jamesath3d/kicad01/kicad01_power_board_for_nuclear_team/pdfs/res_list.pdf

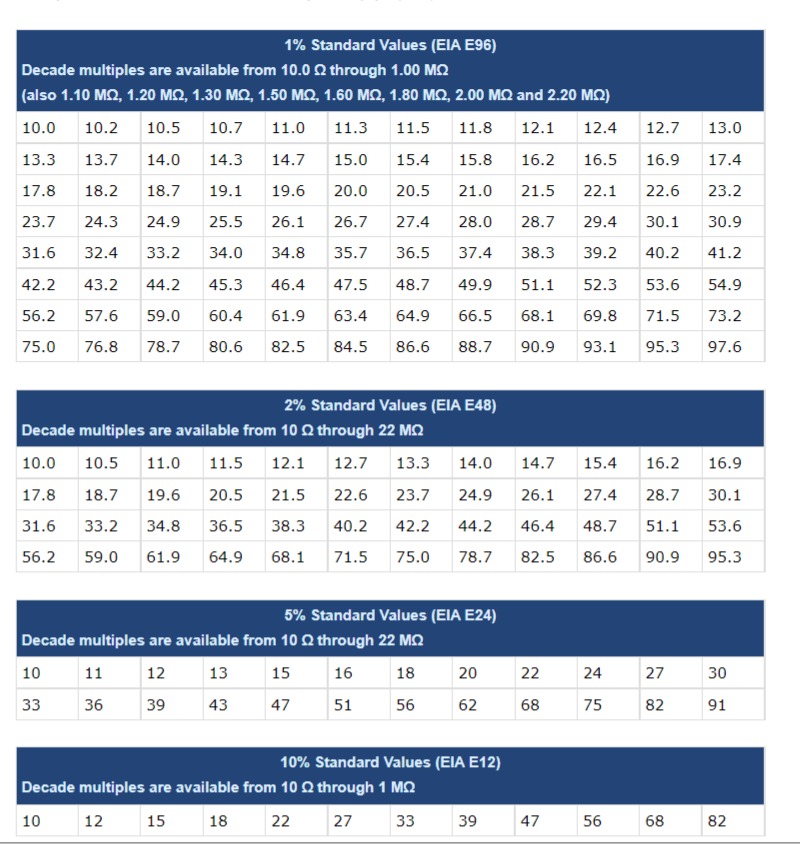
[picture p1: page 1]
