jamesath3d/kicad01/kicad01_power_board_for_nuclear_team/3d/ptc_fuse_2920.step

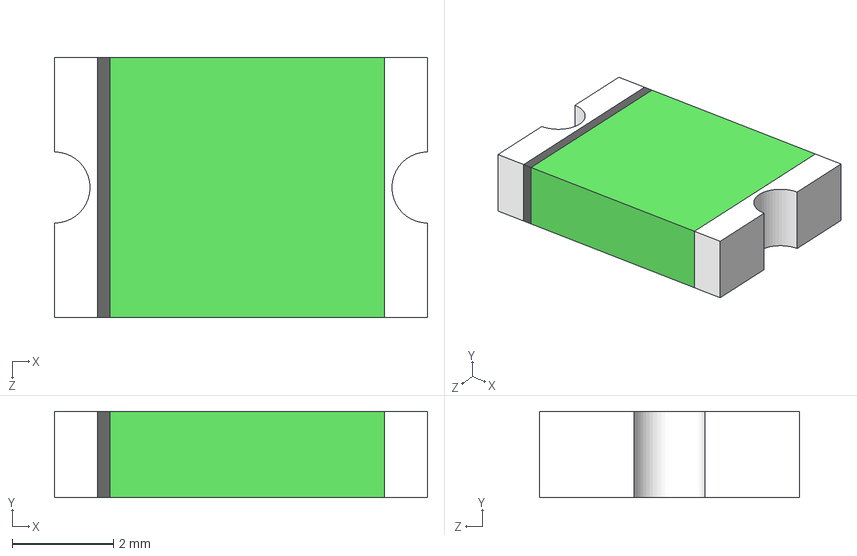
[picture p2: CAD file, 2022-02-18]
kicad01_power_board_for_nuclear_team/3d/ptc_fuse_2920.step
7.36 x 1.70 x 5.12 mm
