jamesath3d/kicad01/kicad01_power_board_for_nuclear_team/kicad01_power_board_for_nuclear_team.step

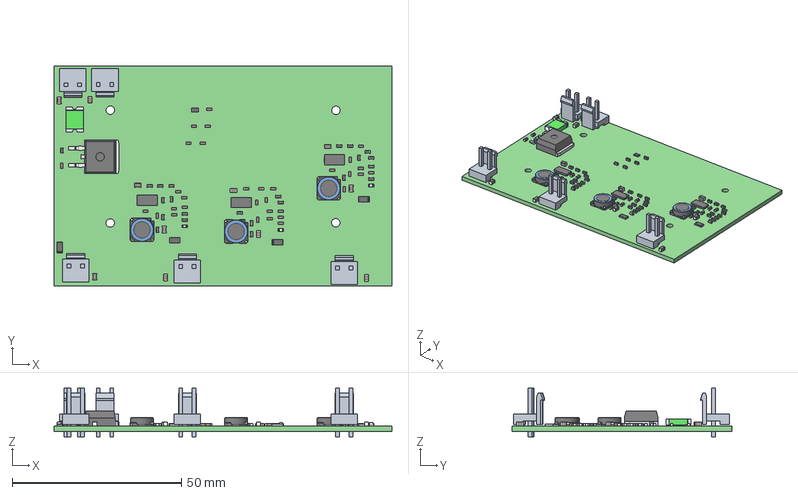
[picture p3: CAD file, 2022-02-25]
kicad01_power_board_for_nuclear_team/kicad01_power_board_for_nuclear_team.step
99.9 x 65.0 x 14.4 mm
kicad01_power_board_for_nuclear_team PCB
