jamesath3d/kicad01/kicad01_power_board_for_nuclear_team/3d/1-1123723-2.step

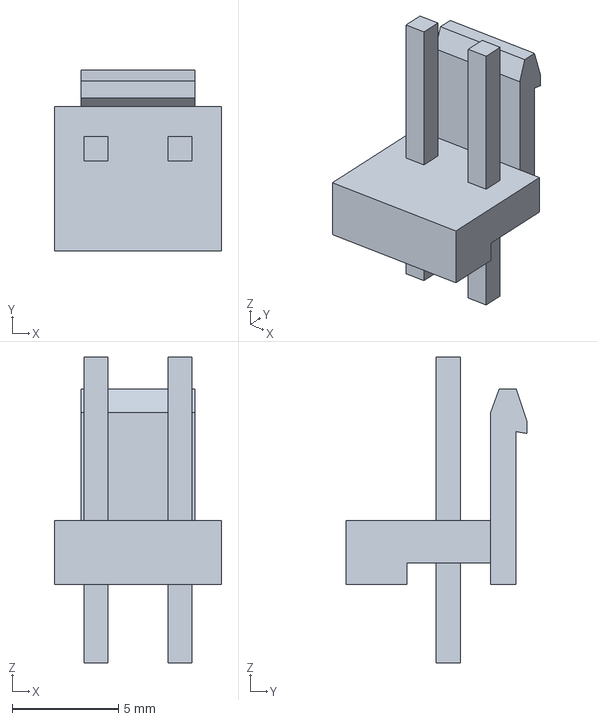
[picture p4: CAD file, 2022-02-18]
kicad01_power_board_for_nuclear_team/3d/1-1123723-2.step
7.86 x 8.50 x 14.4 mm
