jamesath3d/kicad01/kicad01_power_board_for_nuclear_team/pdfs/header_a111830_ENG_CD_1123723_AA4.pdf

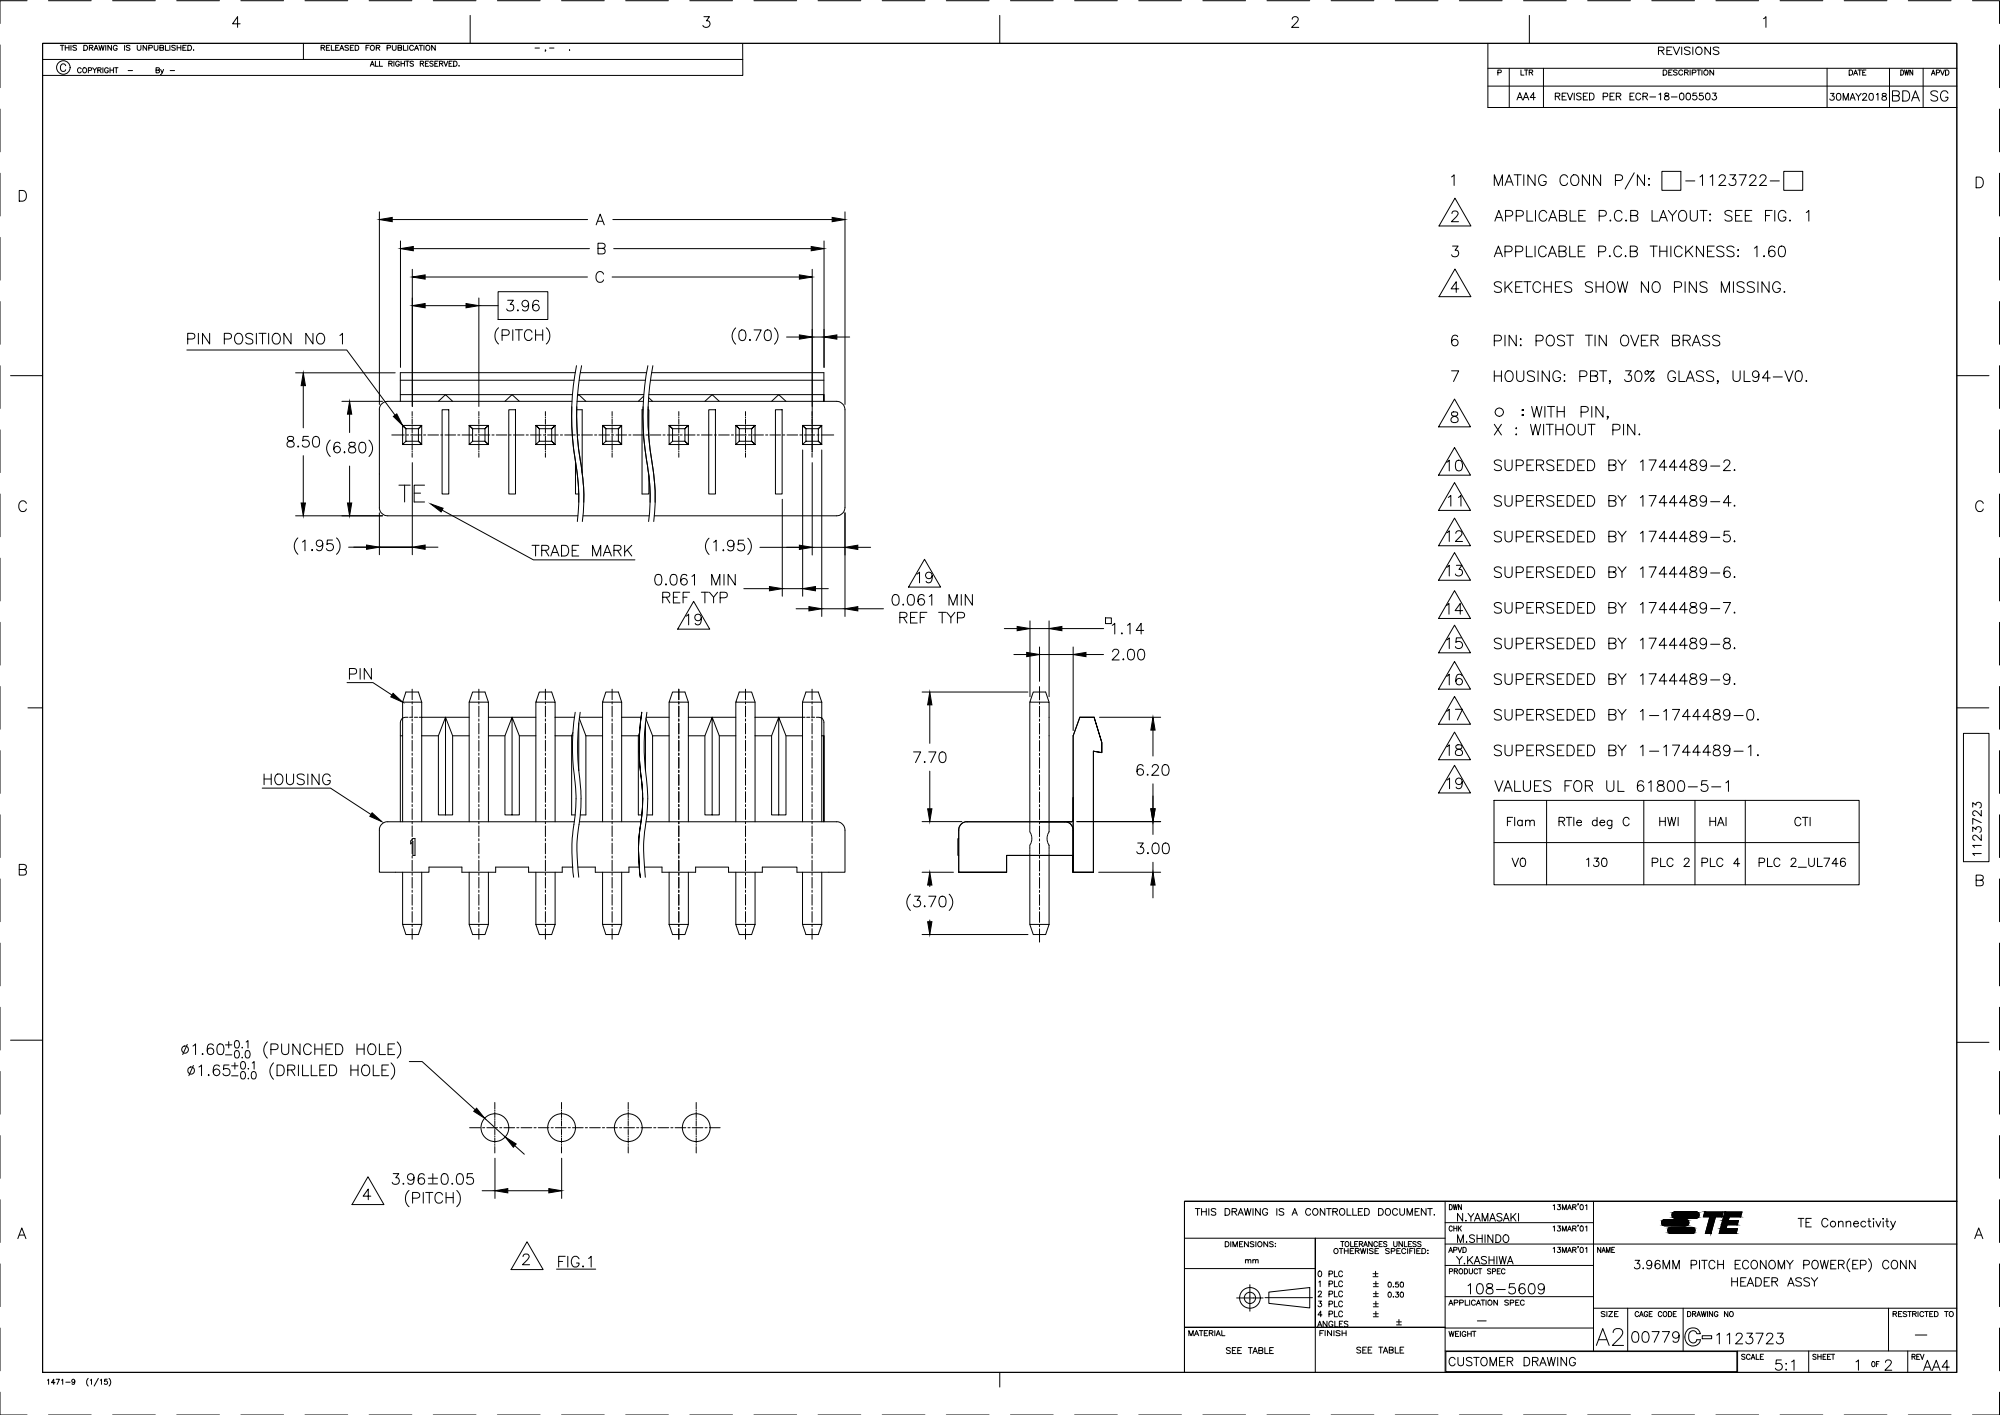
[picture p5: page 1]

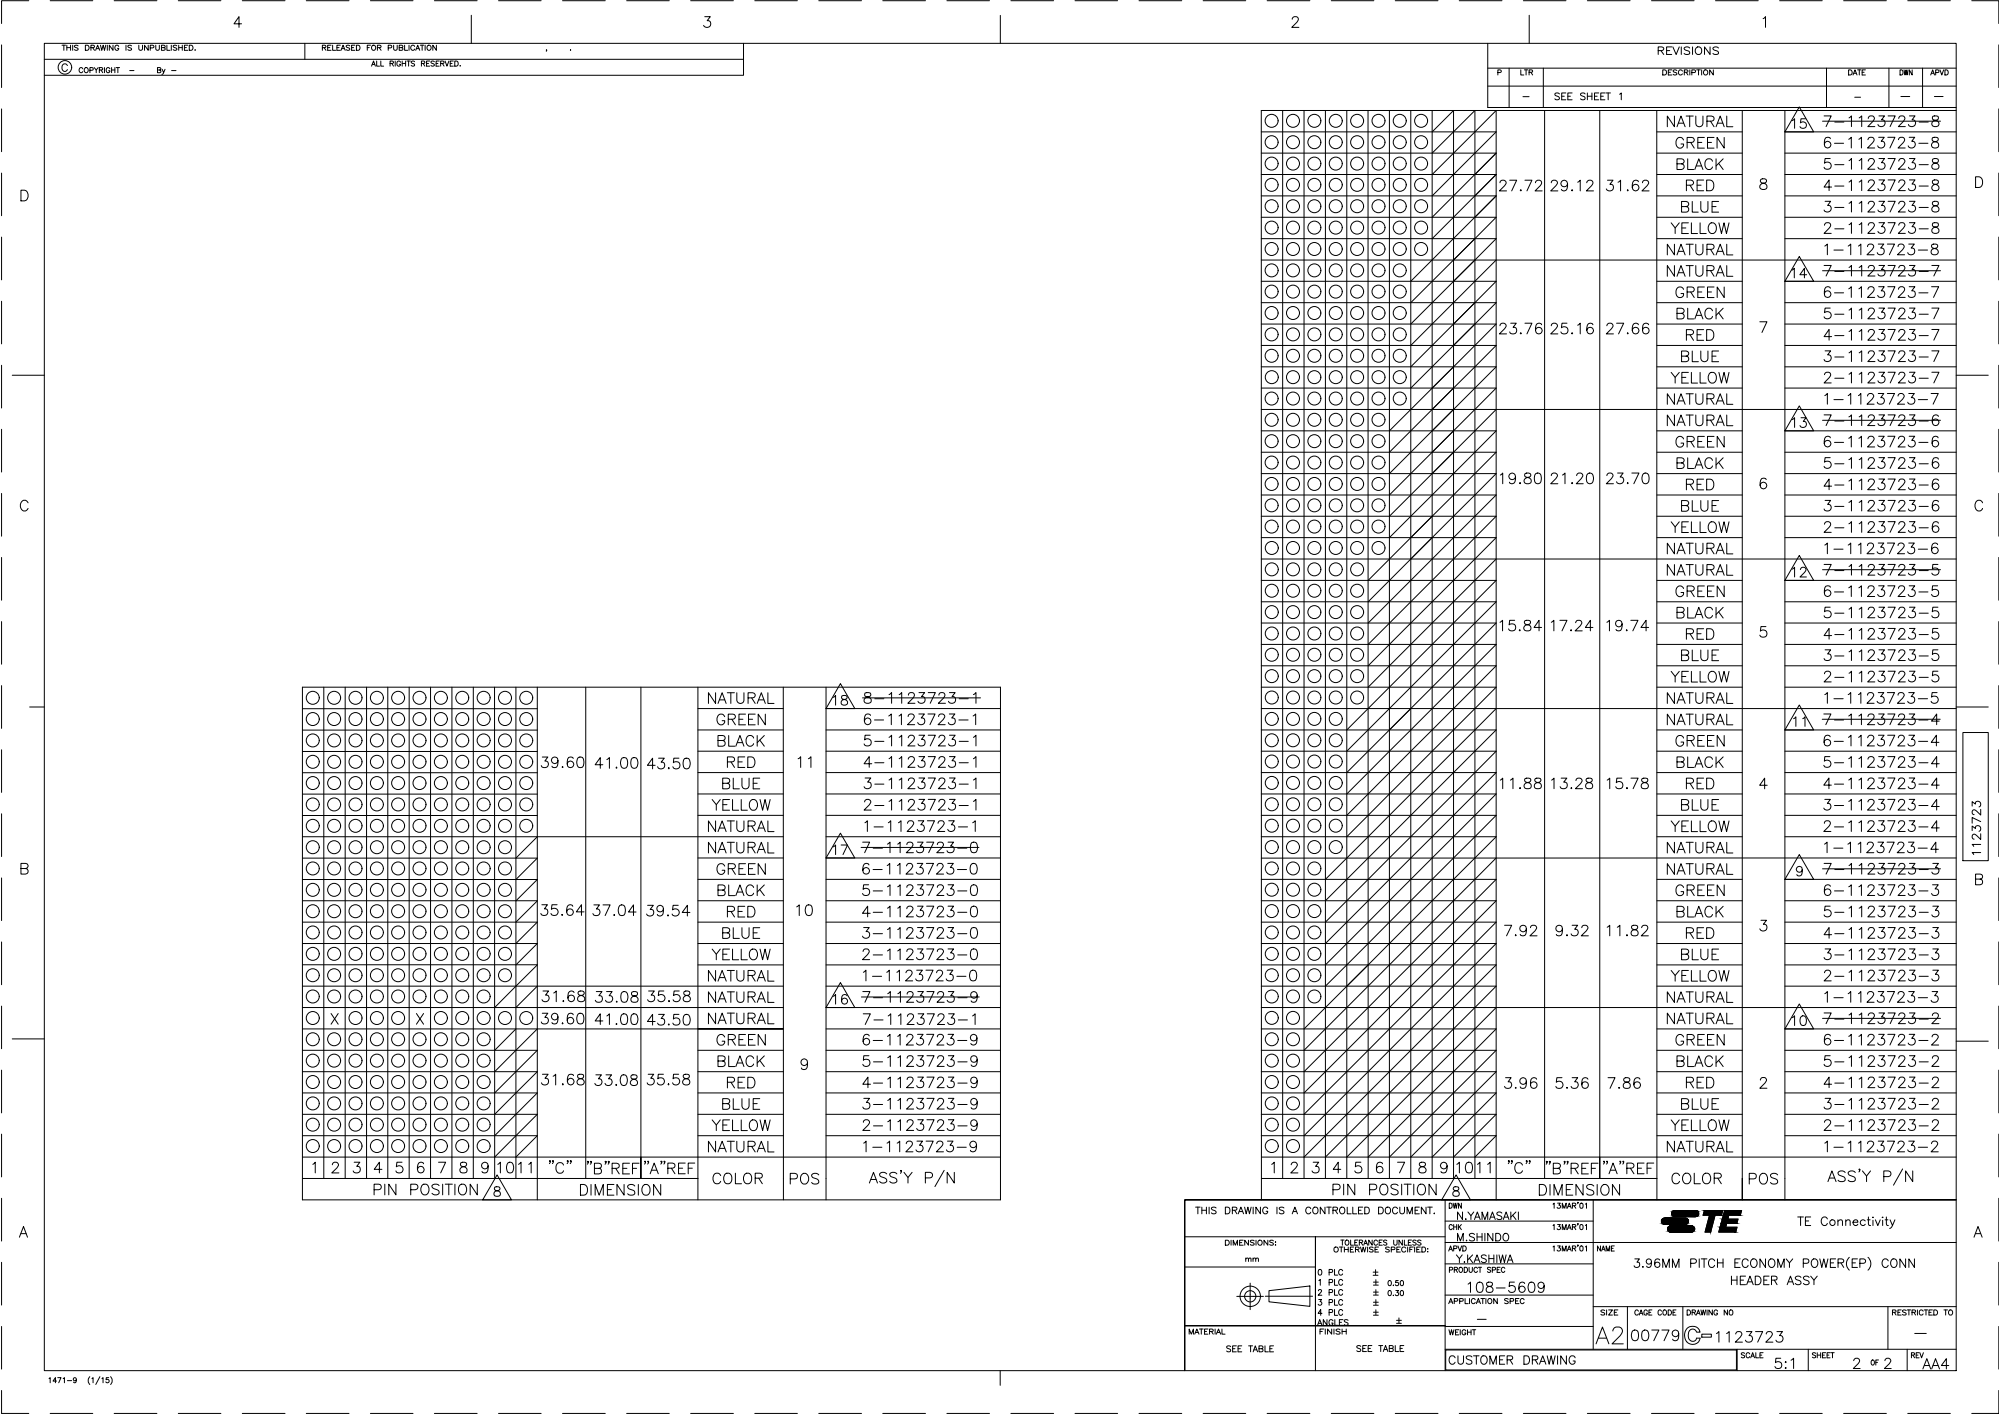
[picture p6: page 2]
