jamesath3d/kicad01/kicad01_power_board_for_nuclear_team/kicad01_power_board_for_nuclear_team.kicad_pcb

## KiCad design kicad01_power_board_for_nuclear_team/kicad01_power_board_for_nuclear_team.kicad_pcb (2022-03-01)

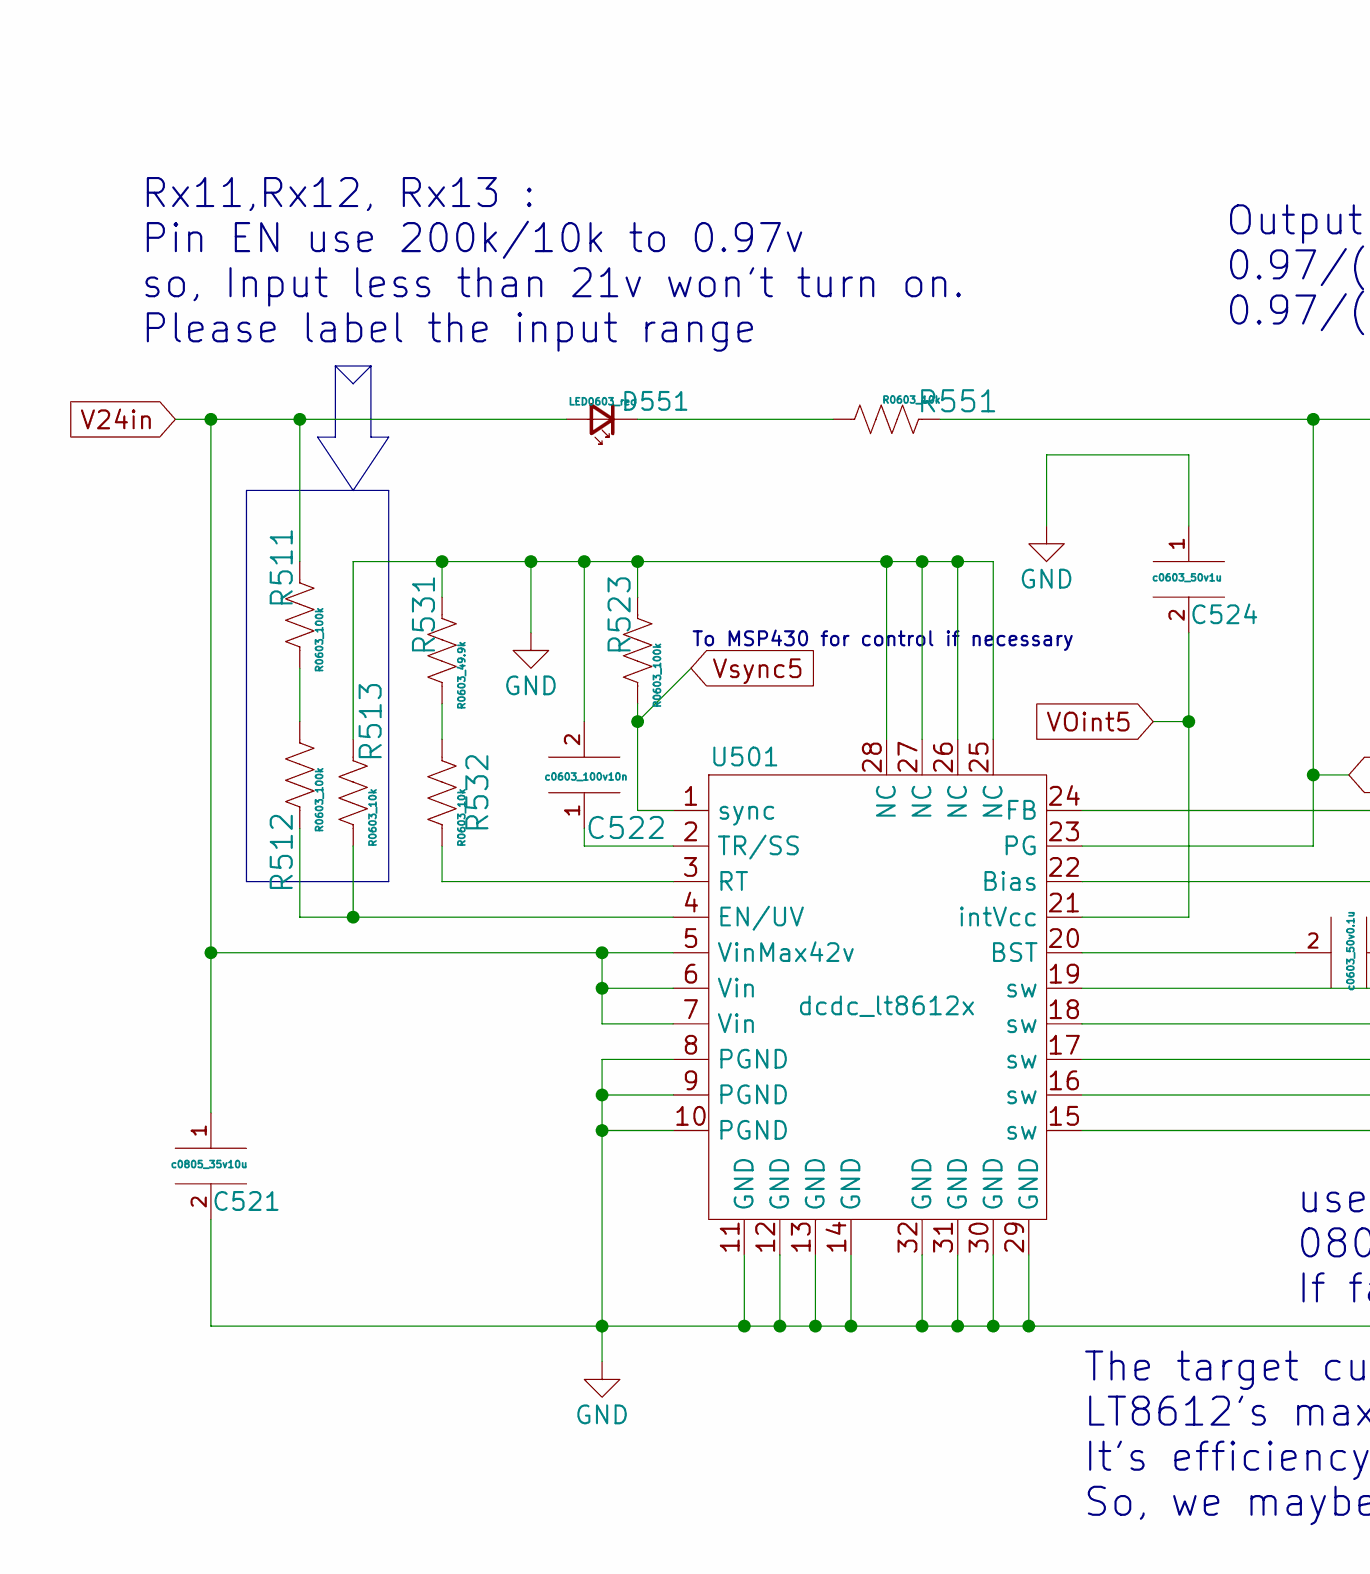
[picture p7: schematic 005_dcdc_5v3a.kicad_sch, part in row 1, column 1]

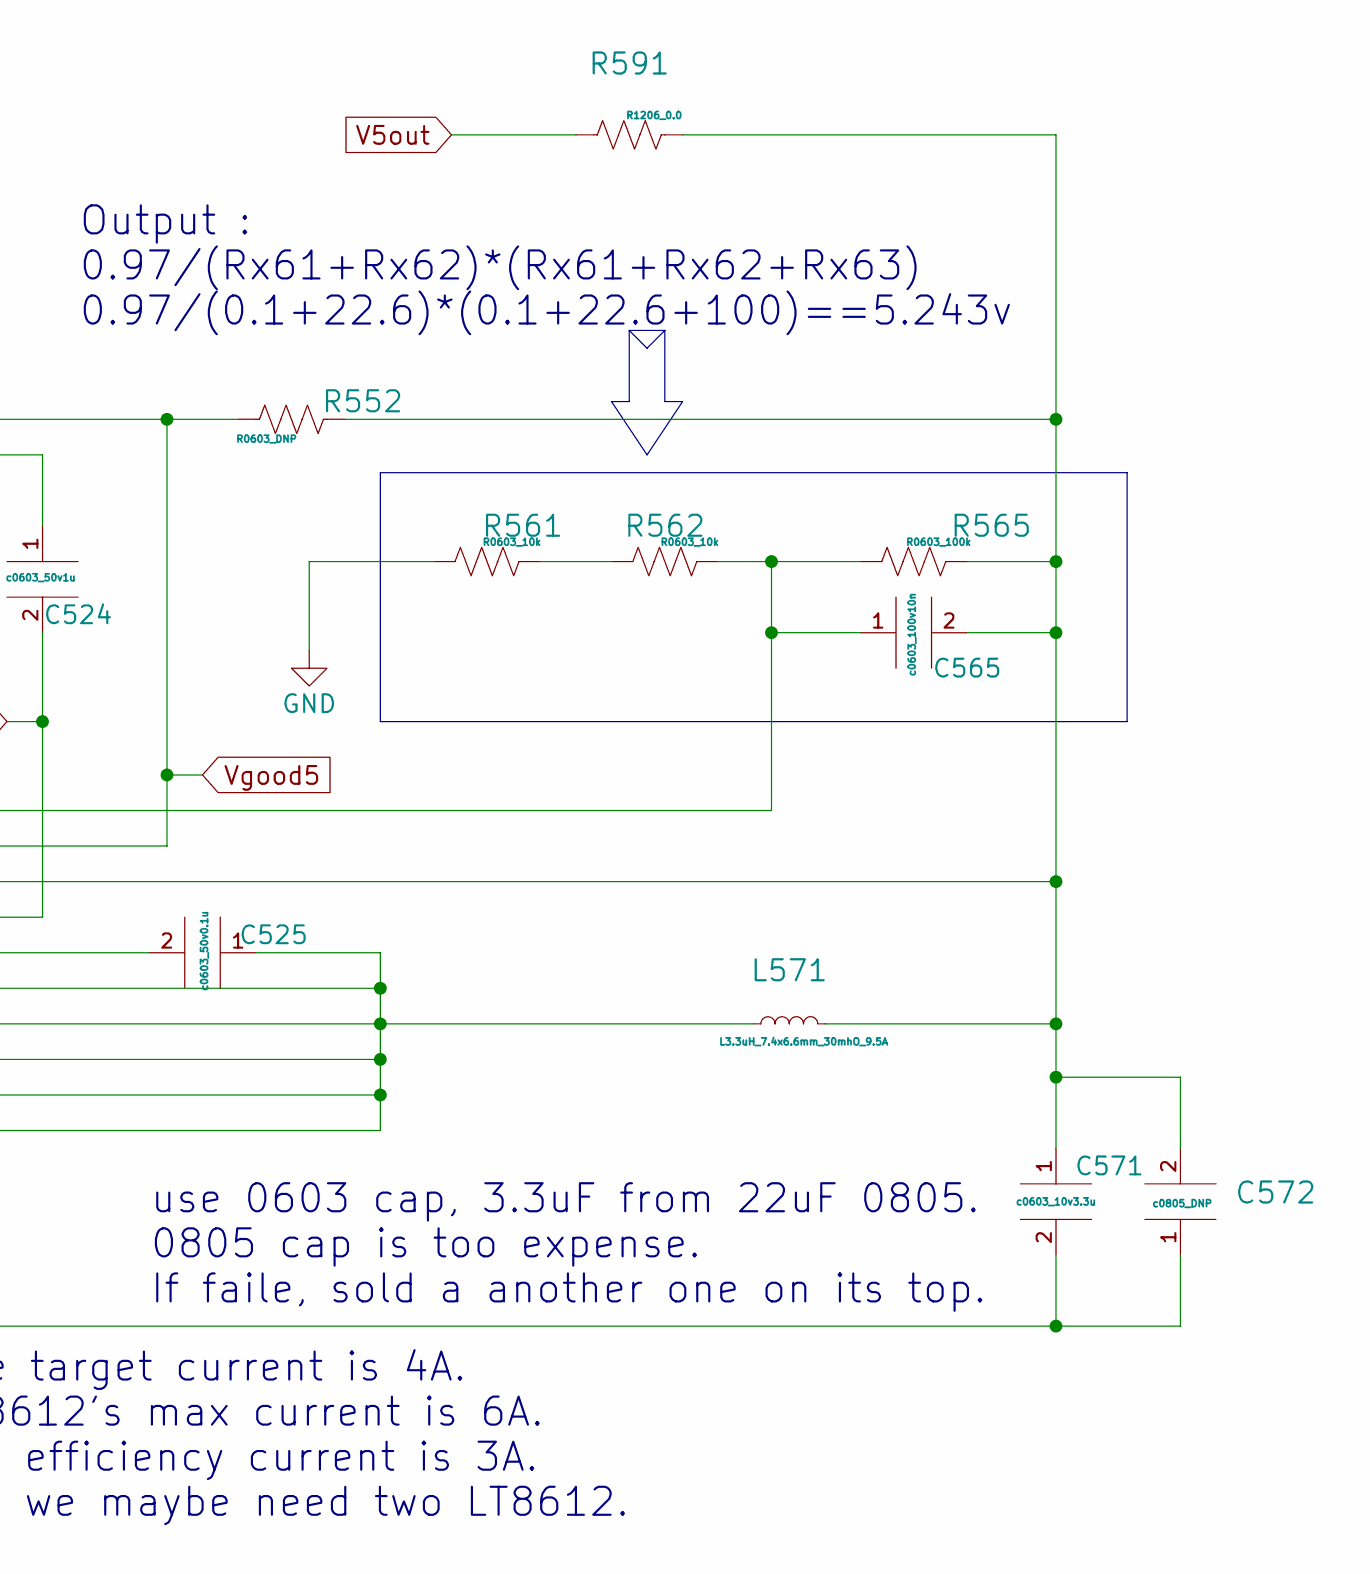
[picture p8: schematic 005_dcdc_5v3a.kicad_sch, part in row 1, column 2]

Parts:
C521: c0805_35v10u; C0805mix0603; PartNum C2012X5R1V106M085AC
C522, C565: c0603_100v10n; C0603; PartNum C1608X7R2A103M080AA
C524: c0603_50v1u; C0603; PartNum C1608X5R1H105K080AB
C525: c0603_50v0.1u; C0603; PartNum CGA3E2X7R1H104M080AA
C571: c0603_10v3.3u; C0603; PartNum C1608X7S1A335K080AC
C572: c0805_DNP; C0805mix0603; PartNum c0805_DNP
D551: LED0603_red; LED0603; PartNum LTST-C190KRKT
L571: L3.3uH_7.4x6.6mm_30mhO_9.5A; L7.1x6.6mm; PartNum ECS-MPIL0630-3R3MC
R511, R512, R523, R565: R0603_100k; C0603; PartNum ERA-3AED104V
R513, R532, R551, R561, R562: R0603_10k; C0603; PartNum ERJ-PA3F1002V
R531: R0603_49.9k; C0603; PartNum ERA-3AED4992V
R552: R0603_DNP; C0603; PartNum R0603_DNP
R591: R1206_0.0; R1206mix0603; PartNum RC1206FR-070RL
U501: dcdc_lt8612x; QFN-28-1EP_3x6mm_P0.5mm_EP1.7x4.75mmX; PartNum 505-LT8612EUDE#PBF-ND

Connections:
GND: C521.2, C522.2, C524.1, C571.2, C572.1, R513.2, R523.2, R531.2, R561.2, U501.8 (PGND), U501.9 (PGND), U501.10 (PGND), U501.11 (GND), U501.12 (GND), U501.13 (GND), U501.14 (GND), U501.25 (NC), U501.26 (NC), U501.27 (NC), U501.28 (NC), U501.29 (GND), U501.30 (GND), U501.31 (GND), U501.32 (GND); also elsewhere on the board
unnamed: C522.1, U501.2 (TR/SS)
unnamed: C525.1, L571.1, U501.15 (sw), U501.16 (sw), U501.17 (sw), U501.18 (sw), U501.19 (sw)
unnamed: C525.2, U501.20 (BST)
unnamed: C565.1, R562.1, R565.2, U501.24 (FB)
unnamed: C565.2, C571.1, C572.2, L571.2, R552.2, R565.1, R591.1, U501.22 (Bias)
unnamed: D551.1 (K), R551.2
unnamed: R511.1, R512.2
unnamed: R512.1, R513.1, U501.4 (EN/UV)
unnamed: R531.1, R532.2
unnamed: R532.1, U501.3 (RT)
unnamed: R561.1, R562.2
V5out: R591.2; also elsewhere on the board
V24in: C521.1, D551.2 (A), R511.2, U501.5 (VinMax42v), U501.6 (Vin), U501.7 (Vin); also elsewhere on the board
VOint5: C524.2, U501.21 (intVcc)
Vgood5: R551.1, R552.1, U501.23 (PG)
Vsync5: R523.1, U501.1 (sync)

Notes on the sheet:
use 0603 cap, 3.3uF from 22uF 0805. 0805 cap is too expense. If faile, sold a another one on its top.
To MSP430 for control if necessary
The target current is 4A. LT8612's max current is 6A. It's efficiency current is 3A. So, we maybe need two LT8612.
Output : 0.97/(Rx61+Rx62)*(Rx61+Rx62+Rx63) 0.97/(0.1+22.6)*(0.1+22.6+100)==5.243v
Rx11,Rx12, Rx13 : Pin EN use 200k/10k to 0.97v so, Input less than 21v won't turn on. Please label the input range

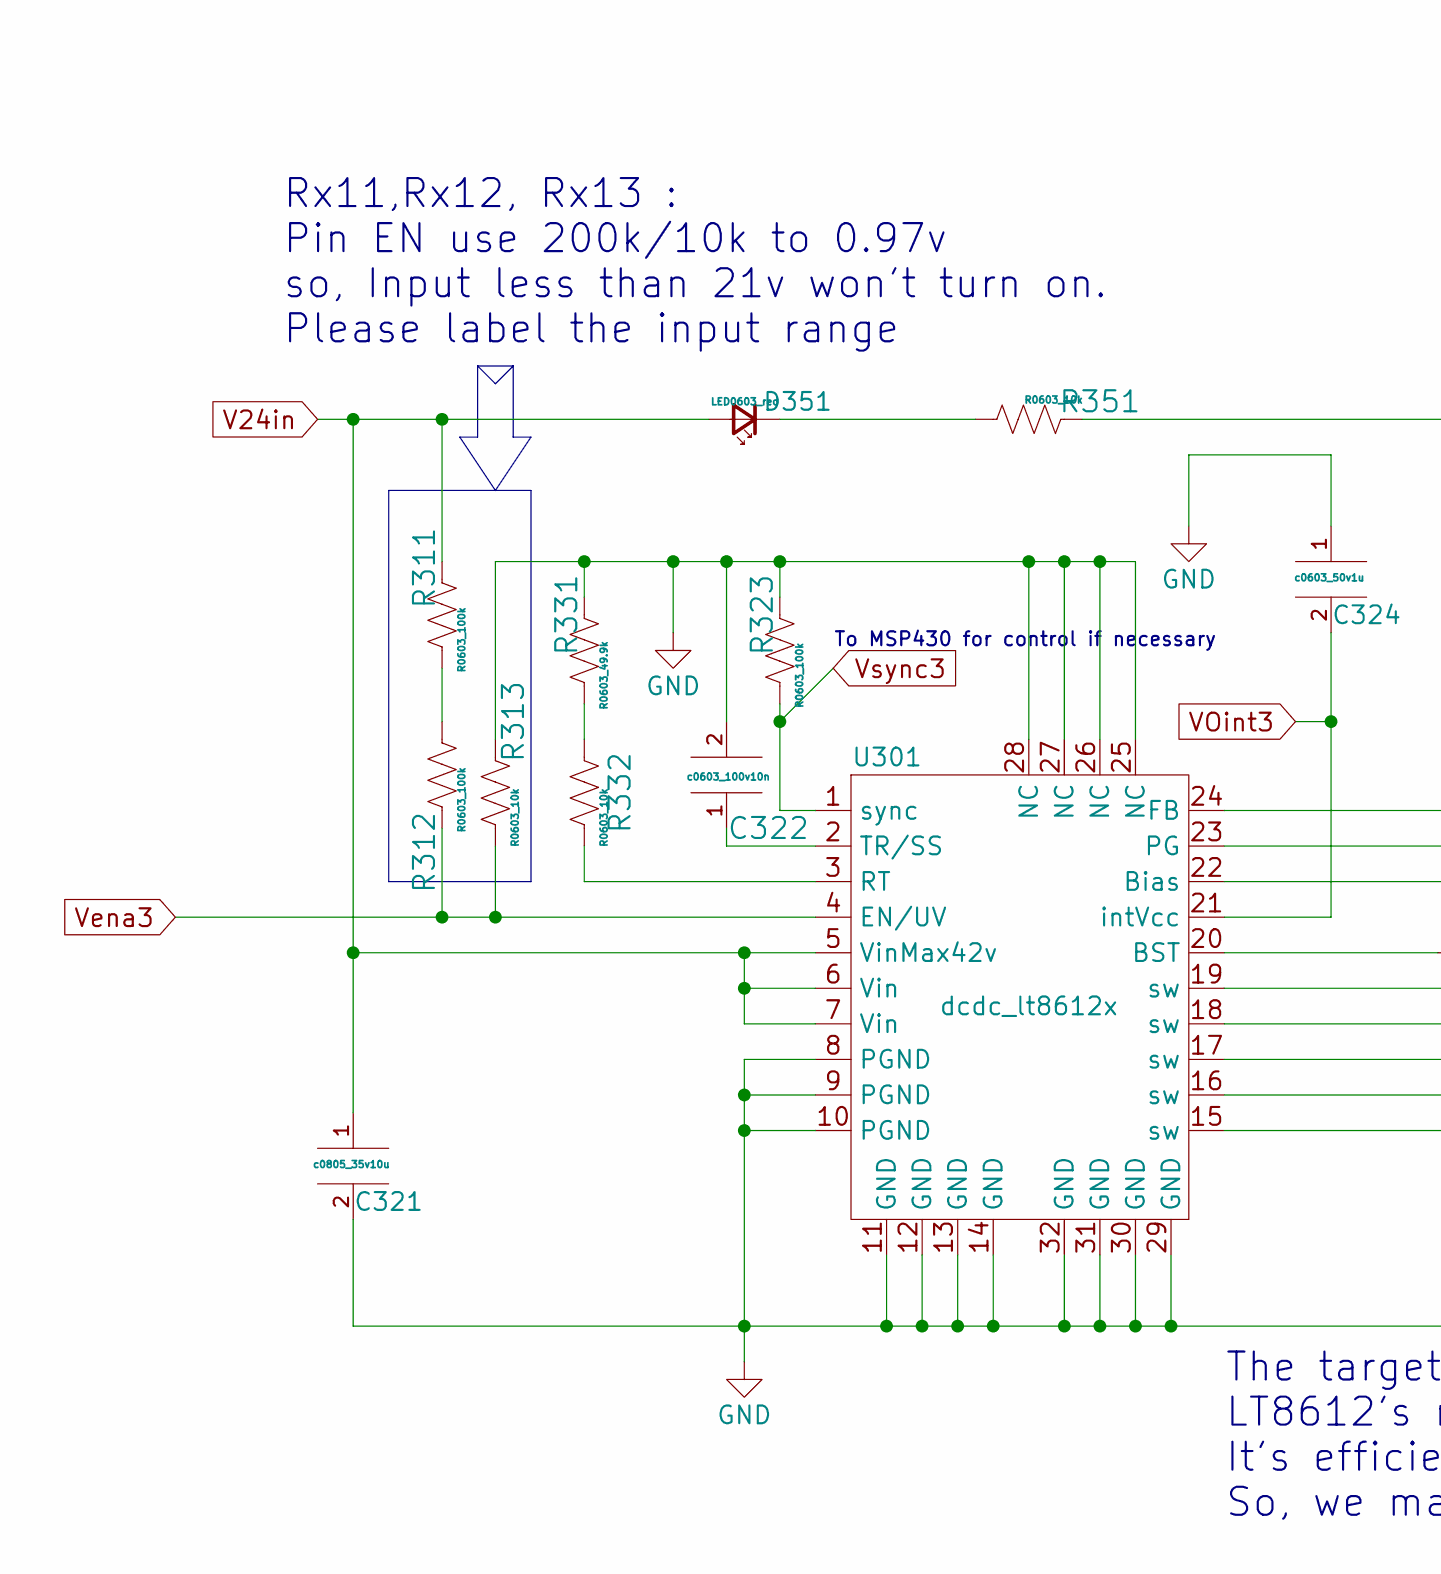
[picture p9: schematic 003_dcdc_18v4a.kicad_sch, part in row 1, column 1]

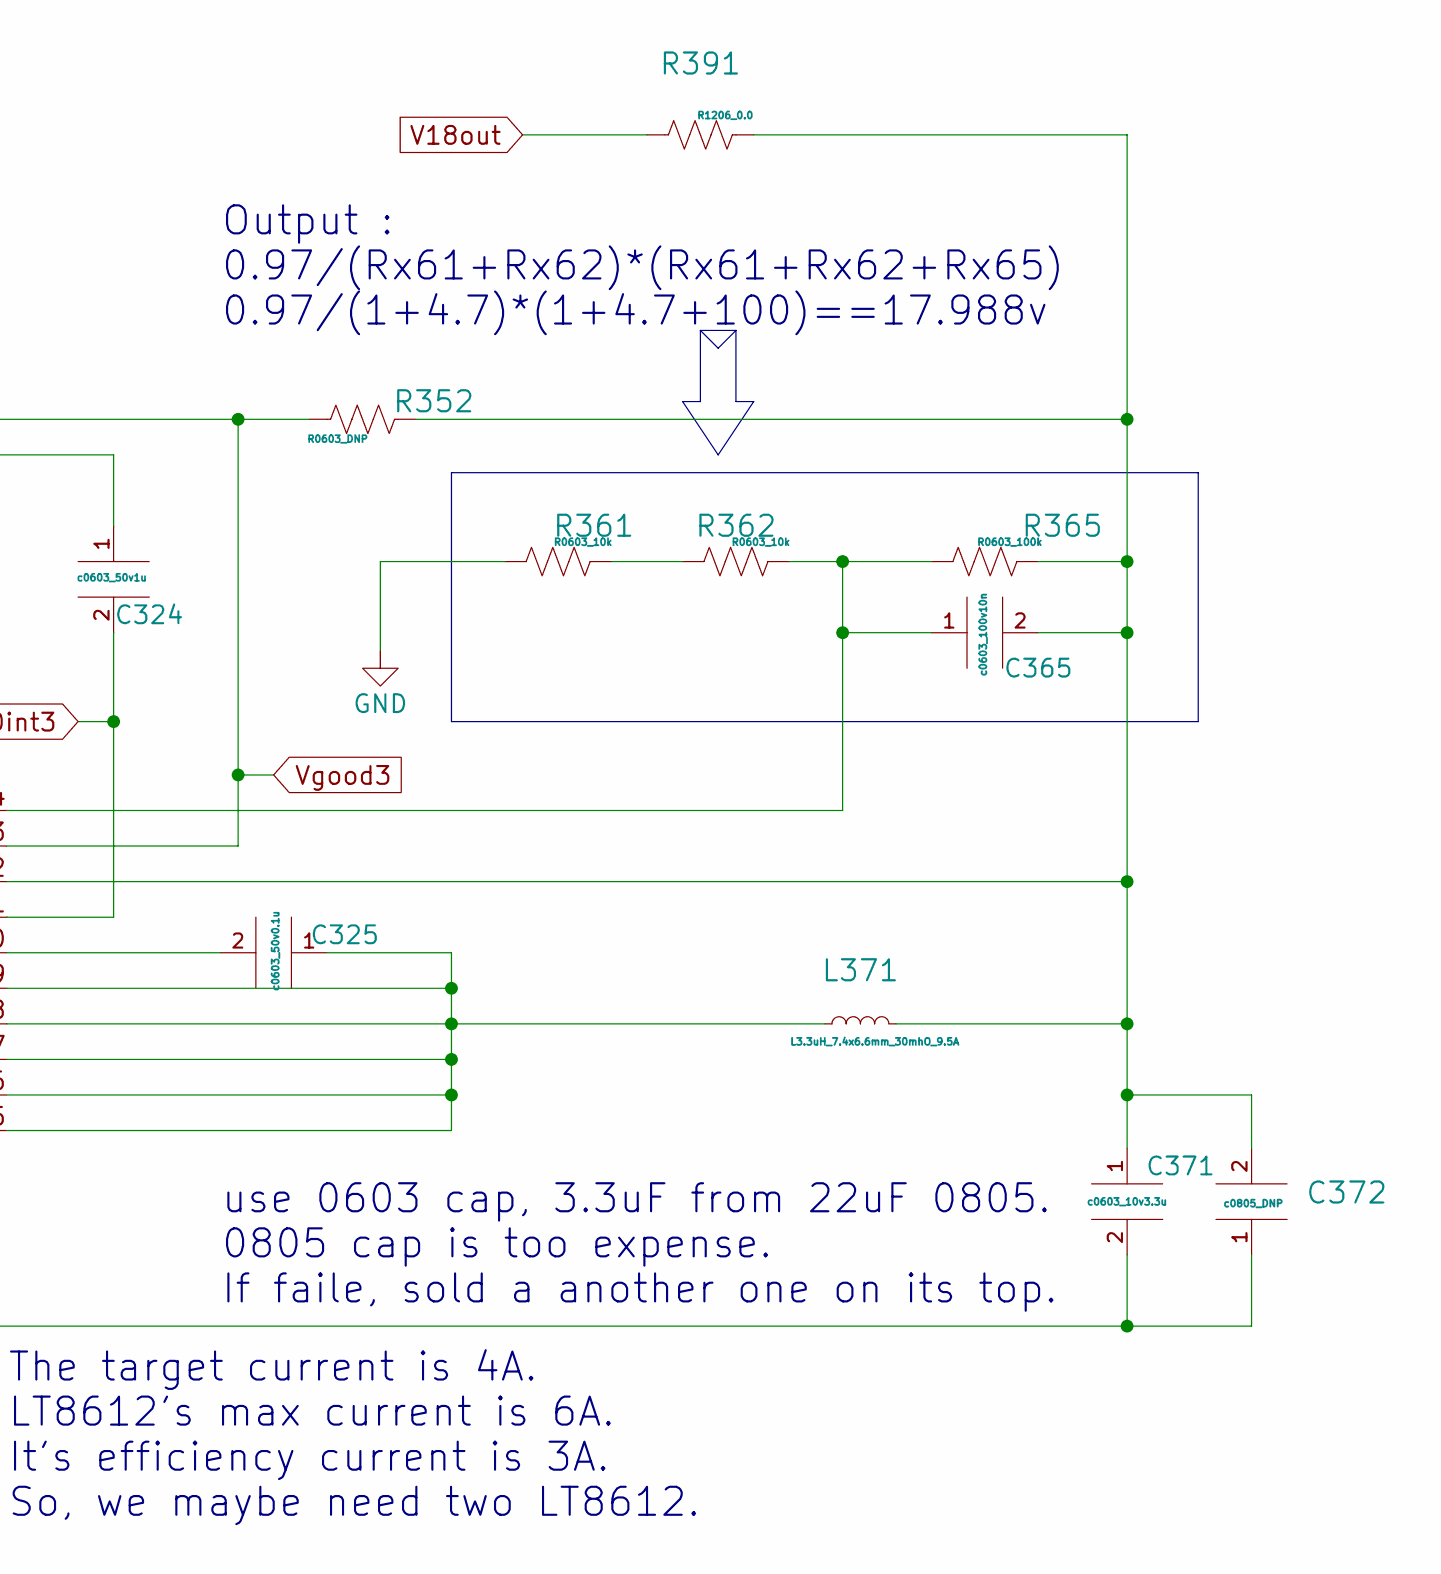
[picture p10: schematic 003_dcdc_18v4a.kicad_sch, part in row 1, column 2]

Parts:
C321: c0805_35v10u; C0805mix0603; PartNum C2012X5R1V106M085AC
C322, C365: c0603_100v10n; C0603; PartNum C1608X7R2A103M080AA
C324: c0603_50v1u; C0603; PartNum C1608X5R1H105K080AB
C325: c0603_50v0.1u; C0603; PartNum CGA3E2X7R1H104M080AA
C371: c0603_10v3.3u; C0603; PartNum C1608X7S1A335K080AC
C372: c0805_DNP; C0805mix0603; PartNum c0805_DNP
D351: LED0603_red; LED0603; PartNum LTST-C190KRKT
L371: L3.3uH_7.4x6.6mm_30mhO_9.5A; L7.1x6.6mm; PartNum ECS-MPIL0630-3R3MC
R311, R312, R323, R365: R0603_100k; R0603; PartNum ERA-3AED104V
R313, R332, R351, R361, R362: R0603_10k; R0603; PartNum ERJ-PA3F1002V
R331: R0603_49.9k; R0603; PartNum ERA-3AED4992V
R352: R0603_DNP; R0603; PartNum R0603_DNP
R391: R1206_0.0; R1206mix0603; PartNum RC1206FR-070RL
U301: dcdc_lt8612x; QFN-28-1EP_3x6mm_P0.5mm_EP1.7x4.75mmX; PartNum 505-LT8612EUDE#PBF-ND

Connections:
GND: C321.2, C322.2, C324.1, C371.2, C372.1, R313.2, R323.2, R331.2, R361.2, U301.8 (PGND), U301.9 (PGND), U301.10 (PGND), U301.11 (GND), U301.12 (GND), U301.13 (GND), U301.14 (GND), U301.25 (NC), U301.26 (NC), U301.27 (NC), U301.28 (NC), U301.29 (GND), U301.30 (GND), U301.31 (GND), U301.32 (GND); also elsewhere on the board
unnamed: C322.1, U301.2 (TR/SS)
unnamed: C325.1, L371.1, U301.15 (sw), U301.16 (sw), U301.17 (sw), U301.18 (sw), U301.19 (sw)
unnamed: C325.2, U301.20 (BST)
unnamed: C365.1, R362.1, R365.2, U301.24 (FB)
unnamed: C365.2, C371.1, C372.2, L371.2, R352.2, R365.1, R391.1, U301.22 (Bias)
unnamed: D351.1 (K), R351.2
unnamed: R311.1, R312.2
unnamed: R331.1, R332.2
unnamed: R332.1, U301.3 (RT)
unnamed: R361.1, R362.2
V18out: R391.2; also elsewhere on the board
V24in: C321.1, D351.2 (A), R311.2, U301.5 (VinMax42v), U301.6 (Vin), U301.7 (Vin); also elsewhere on the board
VOint3: C324.2, U301.21 (intVcc); also elsewhere on the board
Vena3: R312.1, R313.1, U301.4 (EN/UV); also elsewhere on the board
Vgood3: R351.1, R352.1, U301.23 (PG); also elsewhere on the board
Vsync3: R323.1, U301.1 (sync); also elsewhere on the board

Notes on the sheet:
To MSP430 for control if necessary
use 0603 cap, 3.3uF from 22uF 0805. 0805 cap is too expense. If faile, sold a another one on its top.
Output : 0.97/(Rx61+Rx62)*(Rx61+Rx62+Rx65) 0.97/(1+4.7)*(1+4.7+100)==17.988v
Rx11,Rx12, Rx13 : Pin EN use 200k/10k to 0.97v so, Input less than 21v won't turn on. Please label the input range
The target current is 4A. LT8612's max current is 6A. It's efficiency current is 3A. So, we maybe need two LT8612.

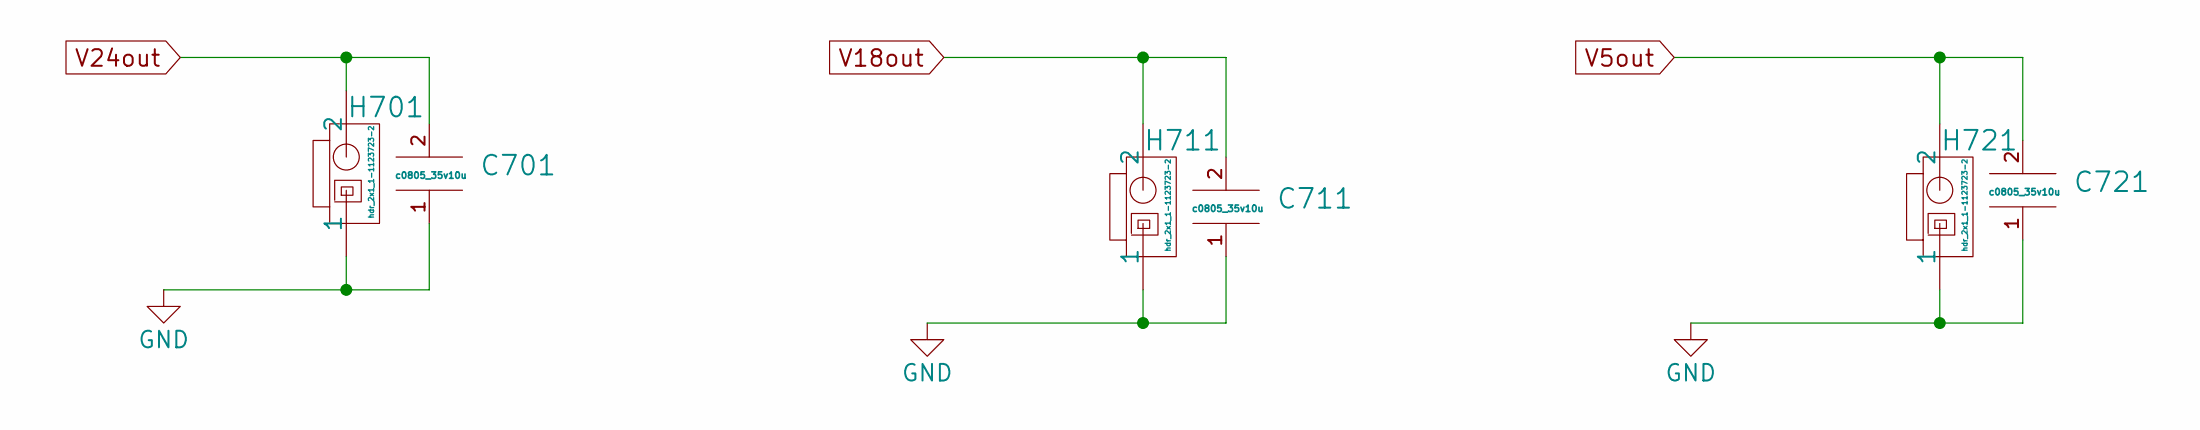
[picture p11: schematic 007_output_socket.kicad_sch]

Parts:
C701, C711, C721: c0805_35v10u; C0805mix0603; PartNum C2012X5R1V106M085AC
H701, H711, H721: hdr_2x1_1-1123723-2; PartNum 1-1123723-2

Connections:
GND: C701.1, C711.1, C721.1, H701.1, H711.1, H721.1; also elsewhere on the board
V5out: C721.2, H721.2; also elsewhere on the board
V18out: C711.2, H711.2; also elsewhere on the board
V24out: C701.2, H701.2; also elsewhere on the board

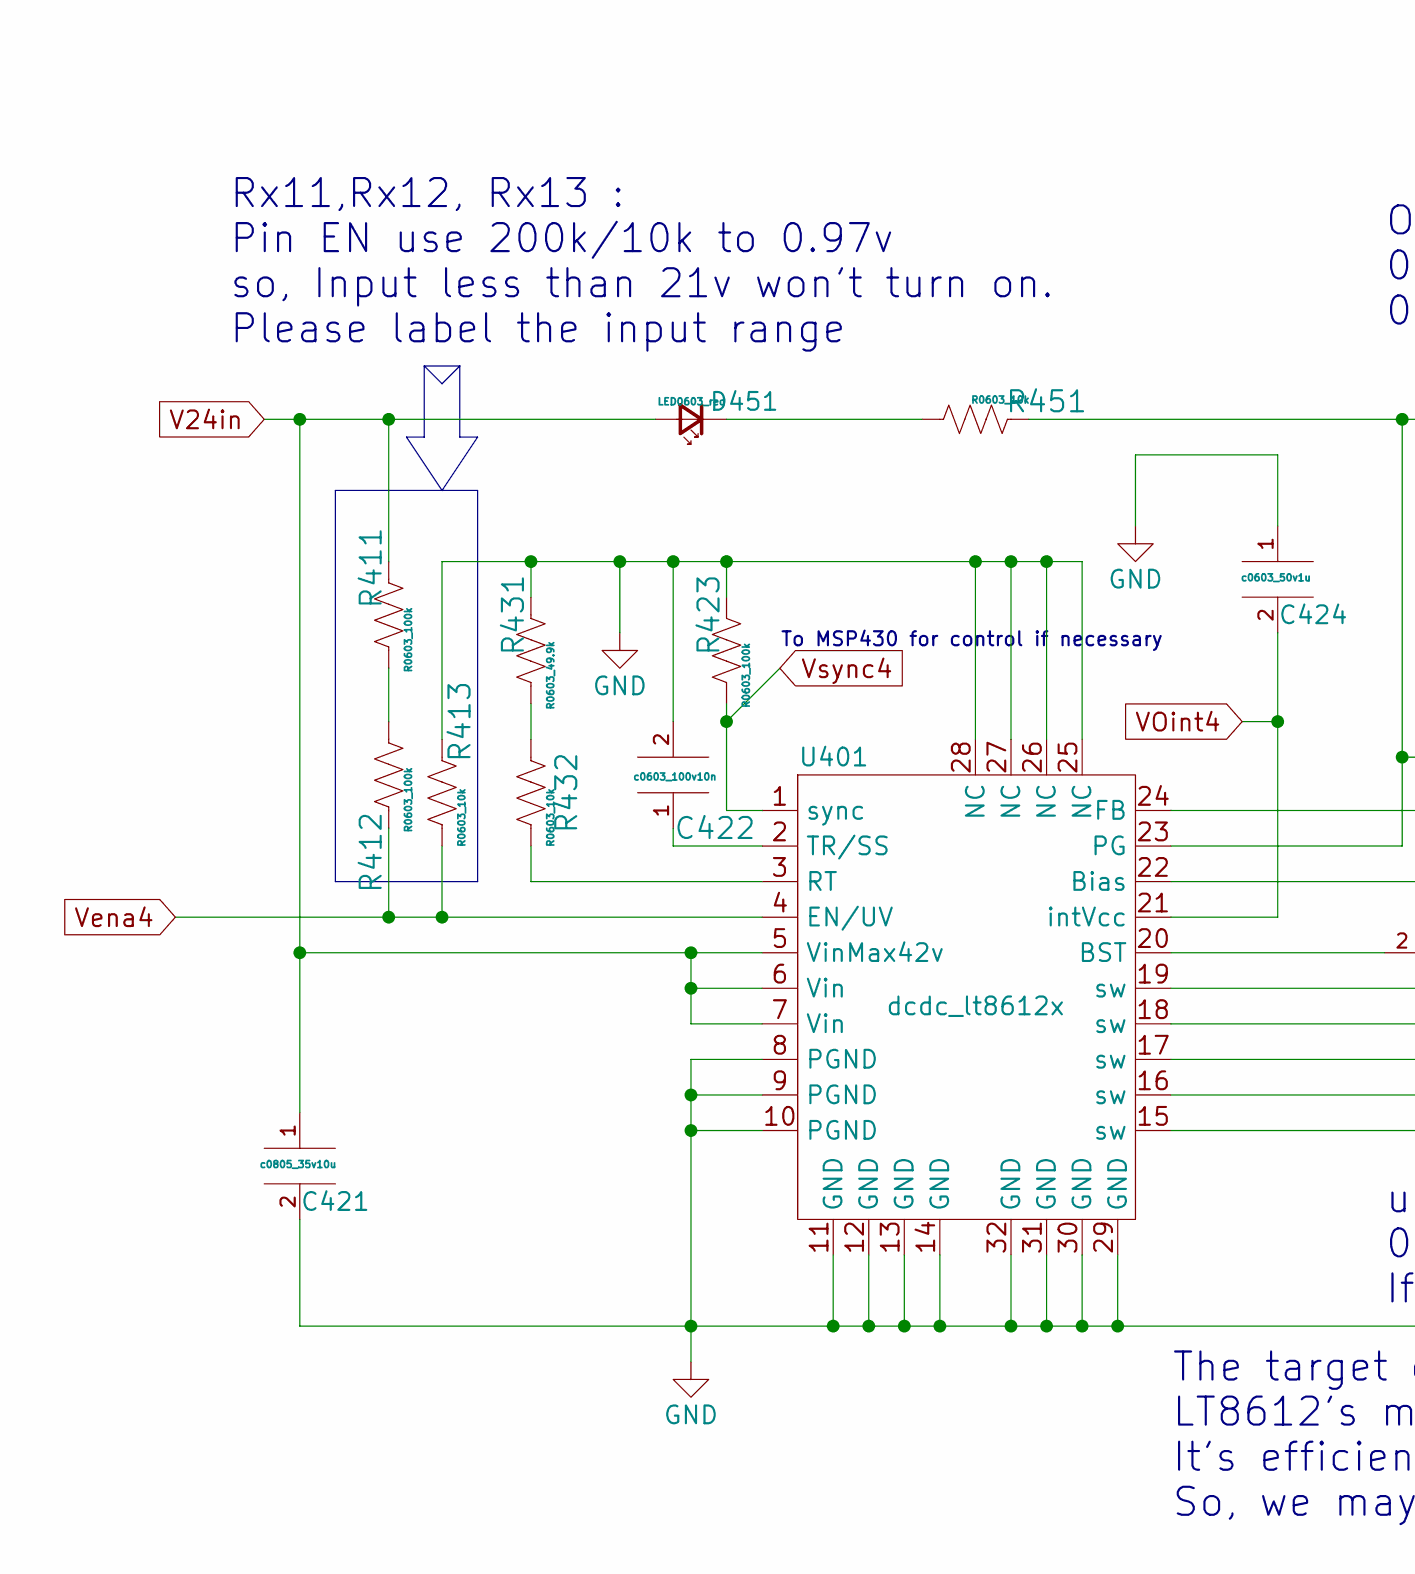
[picture p12: schematic 004_dcdc_18v4a.kicad_sch, part in row 1, column 1]

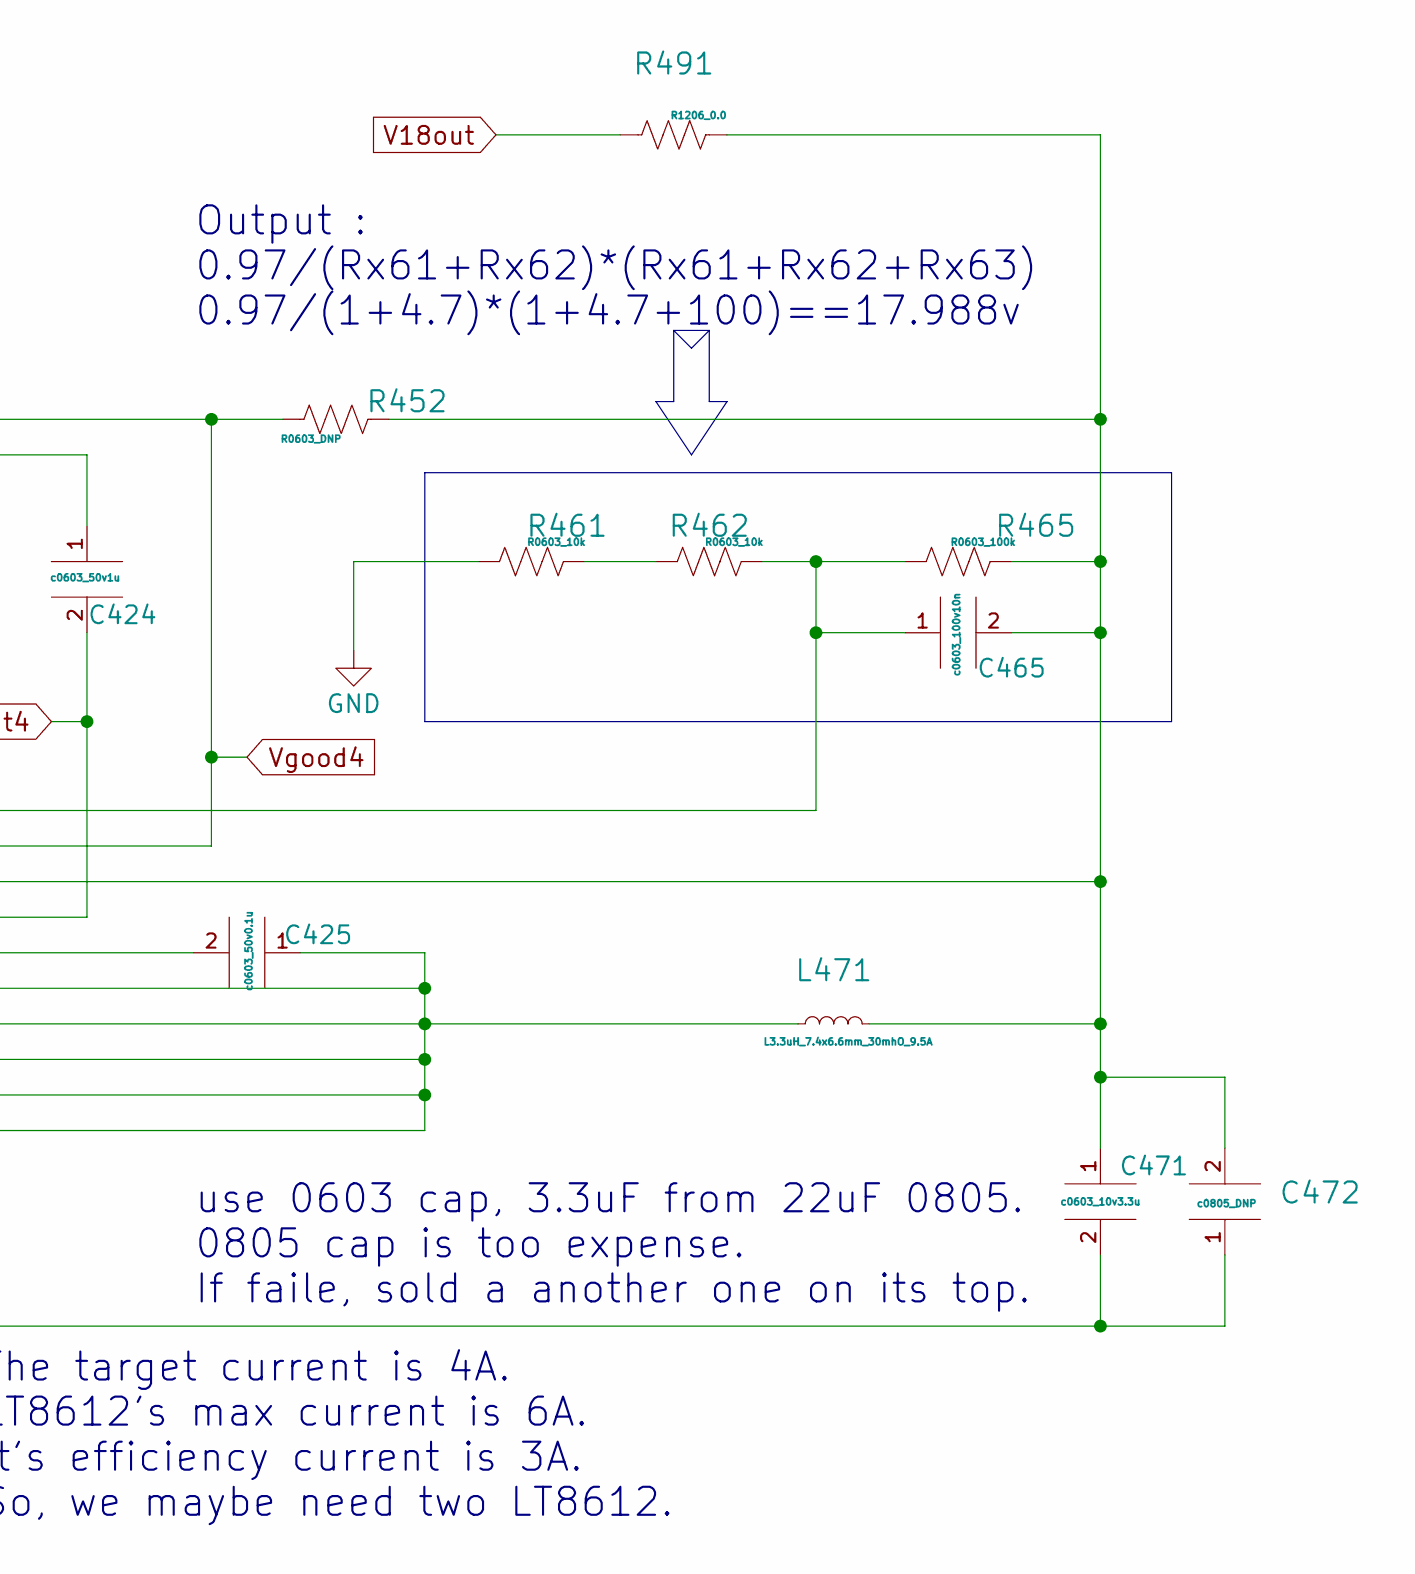
[picture p13: schematic 004_dcdc_18v4a.kicad_sch, part in row 1, column 2]

Parts:
C421: c0805_35v10u; C0805mix0603; PartNum C2012X5R1V106M085AC
C422, C465: c0603_100v10n; C0603; PartNum C1608X7R2A103M080AA
C424: c0603_50v1u; C0603; PartNum C1608X5R1H105K080AB
C425: c0603_50v0.1u; C0603; PartNum CGA3E2X7R1H104M080AA
C471: c0603_10v3.3u; C0603; PartNum C1608X7S1A335K080AC
C472: c0805_DNP; C0805mix0603; PartNum c0805_DNP
D451: LED0603_red; LED0603; PartNum LTST-C190KRKT
L471: L3.3uH_7.4x6.6mm_30mhO_9.5A; L7.1x6.6mm; PartNum ECS-MPIL0630-3R3MC
R411, R412, R423, R465: R0603_100k; R0603; PartNum ERA-3AED104V
R413, R432, R451, R461, R462: R0603_10k; R0603; PartNum ERJ-PA3F1002V
R431: R0603_49.9k; R0603; PartNum ERA-3AED4992V
R452: R0603_DNP; R0603; PartNum R0603_DNP
R491: R1206_0.0; R1206mix0603; PartNum RC1206FR-070RL
U401: dcdc_lt8612x; QFN-28-1EP_3x6mm_P0.5mm_EP1.7x4.75mmX; PartNum 505-LT8612EUDE#PBF-ND

Connections:
GND: C421.2, C422.2, C424.1, C471.2, C472.1, R413.2, R423.2, R431.2, R461.2, U401.8 (PGND), U401.9 (PGND), U401.10 (PGND), U401.11 (GND), U401.12 (GND), U401.13 (GND), U401.14 (GND), U401.25 (NC), U401.26 (NC), U401.27 (NC), U401.28 (NC), U401.29 (GND), U401.30 (GND), U401.31 (GND), U401.32 (GND); also elsewhere on the board
unnamed: C422.1, U401.2 (TR/SS)
unnamed: C425.1, L471.1, U401.15 (sw), U401.16 (sw), U401.17 (sw), U401.18 (sw), U401.19 (sw)
unnamed: C425.2, U401.20 (BST)
unnamed: C465.1, R462.1, R465.2, U401.24 (FB)
unnamed: C465.2, C471.1, C472.2, L471.2, R452.2, R465.1, R491.1, U401.22 (Bias)
unnamed: D451.1 (K), R451.2
unnamed: R411.1, R412.2
unnamed: R431.1, R432.2
unnamed: R432.1, U401.3 (RT)
unnamed: R461.1, R462.2
V18out: R491.2; also elsewhere on the board
V24in: C421.1, D451.2 (A), R411.2, U401.5 (VinMax42v), U401.6 (Vin), U401.7 (Vin); also elsewhere on the board
VOint4: C424.2, U401.21 (intVcc); also elsewhere on the board
Vena4: R412.1, R413.1, U401.4 (EN/UV); also elsewhere on the board
Vgood4: R451.1, R452.1, U401.23 (PG); also elsewhere on the board
Vsync4: R423.1, U401.1 (sync); also elsewhere on the board

Notes on the sheet:
Output : 0.97/(Rx61+Rx62)*(Rx61+Rx62+Rx63) 0.97/(1+4.7)*(1+4.7+100)==17.988v
Rx11,Rx12, Rx13 : Pin EN use 200k/10k to 0.97v so, Input less than 21v won't turn on. Please label the input range
use 0603 cap, 3.3uF from 22uF 0805. 0805 cap is too expense. If faile, sold a another one on its top.
The target current is 4A. LT8612's max current is 6A. It's efficiency current is 3A. So, we maybe need two LT8612.
To MSP430 for control if necessary
