jamesath3d/kicad01/kicad01_power_board_for_nuclear_team/kicad01_power_board_for_nuclear_team.kicad_pcb

## KiCad design kicad01_power_board_for_nuclear_team/kicad01_power_board_for_nuclear_team.kicad_pcb (continued)

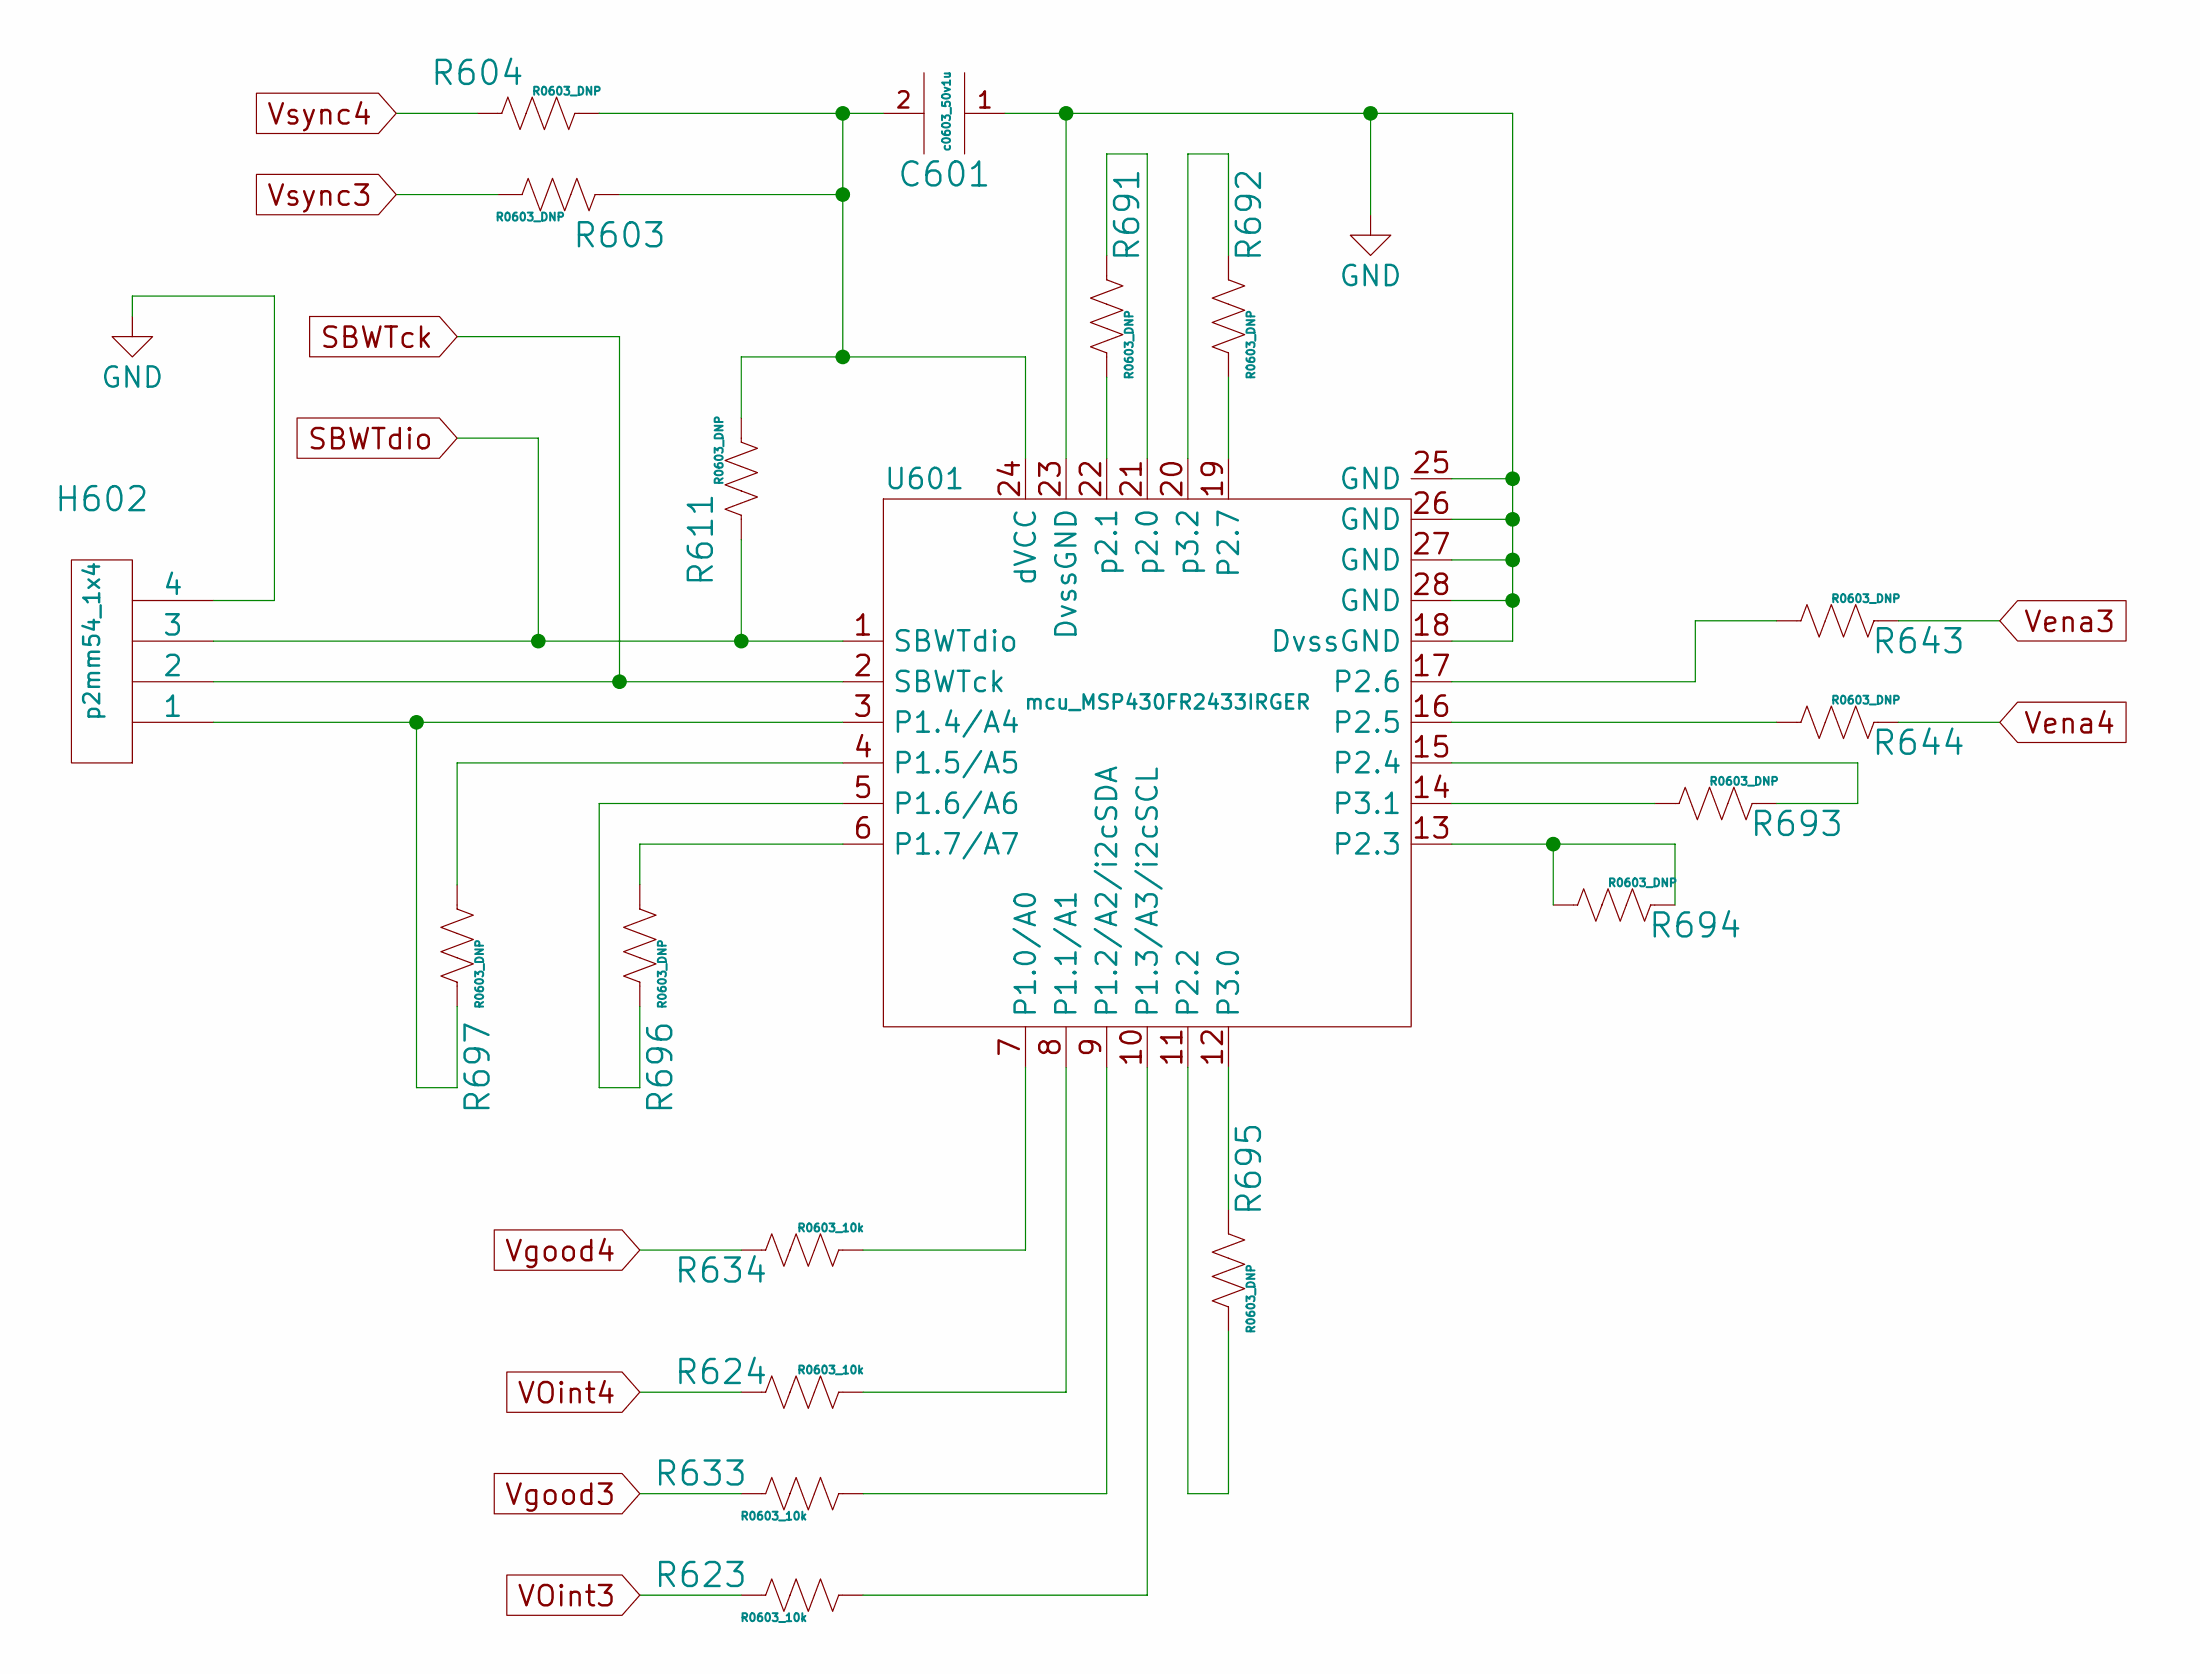
[picture p14: schematic 006_msp430.kicad_sch]

Parts:
C601: c0603_50v1u; C0603; PartNum C1608X5R1H105K080AB
H602: p2mm54_1x4; PartNum 3M156515-04-ND
R603, R604, R611, R643, R644, R691, R692, R693, R694, R695, R696, R697: R0603_DNP; R0603; PartNum R0603_DNP
R623, R624, R633, R634: R0603_10k; R0603; PartNum ERJ-PA3F1002V
U601: mcu_MSP430FR2433IRGER; QFN-24-1EP_4x4mm_P0.5mm_EP2.8x2.8mmX; PartNum MSP430FR2433IRGER

Connections:
GND: C601.1, H602.4, U601.18 (DvssGND), U601.23 (DvssGND), U601.25 (GND), U601.26 (GND), U601.27 (GND), U601.28 (GND); also elsewhere on the board
unnamed: C601.2, R603.2, R604.1, R611.1, U601.24 (dVCC)
unnamed: H602.1, R697.1, U601.3 (P1.4/A4)
unnamed: R623.2, U601.10 (P1.3/A3/i2cSCL)
unnamed: R624.1, U601.8 (P1.1/A1)
unnamed: R633.2, U601.9 (P1.2/A2/i2cSDA)
unnamed: R634.1, U601.7 (P1.0/A0)
unnamed: R643.2, U601.17 (P2.6)
unnamed: R644.2, U601.16 (P2.5)
unnamed: R691.1, U601.22 (p2.1)
unnamed: R691.2, U601.21 (p2.0)
unnamed: R692.1, U601.19 (P2.7)
unnamed: R692.2, U601.20 (p3.2)
unnamed: R693.1, U601.15 (P2.4)
unnamed: R693.2, U601.14 (P3.1)
unnamed: R694.1, R694.2, U601.13 (P2.3)
unnamed: R695.1, U601.11 (P2.2)
unnamed: R695.2, U601.12 (P3.0)
unnamed: R696.1, U601.5 (P1.6/A6)
unnamed: R696.2, U601.6 (P1.7/A7)
unnamed: R697.2, U601.4 (P1.5/A5)
SBWTck: H602.2, U601.2 (SBWTck)
SBWTdio: H602.3, R611.2, U601.1 (SBWTdio)
VOint3: R623.1; also elsewhere on the board
VOint4: R624.2; also elsewhere on the board
Vena3: R643.1; also elsewhere on the board
Vena4: R644.1; also elsewhere on the board
Vgood3: R633.1; also elsewhere on the board
Vgood4: R634.2; also elsewhere on the board
Vsync3: R603.1; also elsewhere on the board
Vsync4: R604.2; also elsewhere on the board

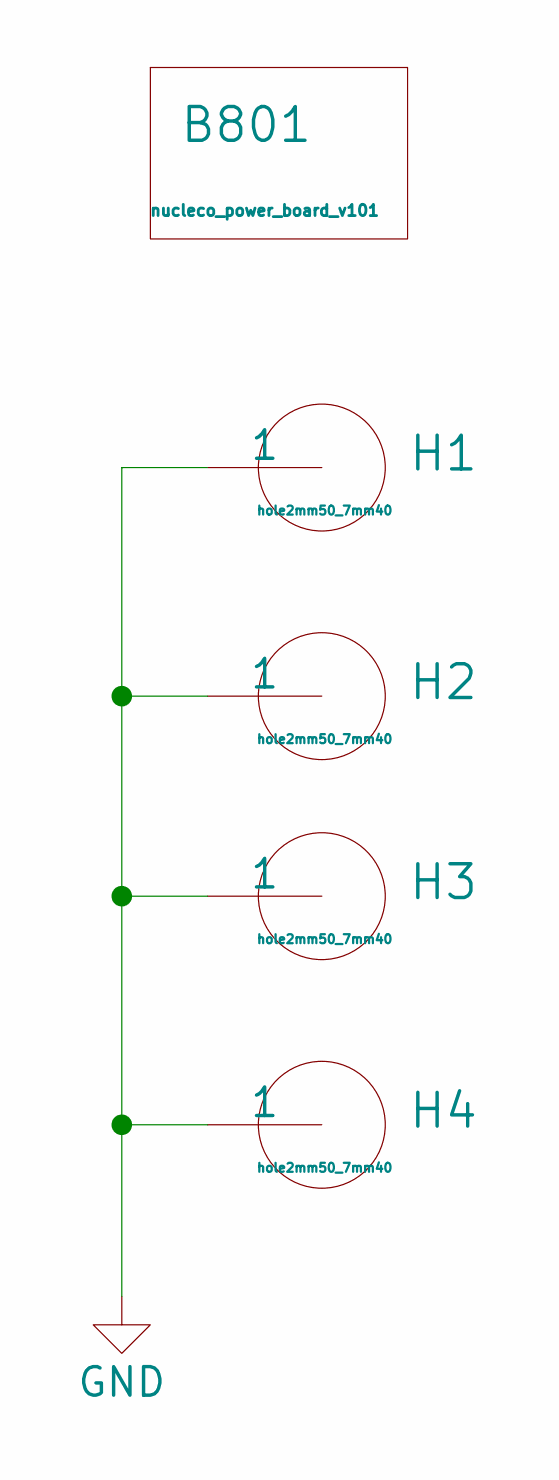
[picture p15: schematic 008_board_and_testpoint.kicad_sch]

Parts:
B801: nucleco_power_board_v101; PartNum DNP
H1, H2, H3, H4: hole2mm50_7mm40; PartNum hole2mm50_DNP

Connections:
GND: H1.1, H2.1, H3.1, H4.1; also elsewhere on the board

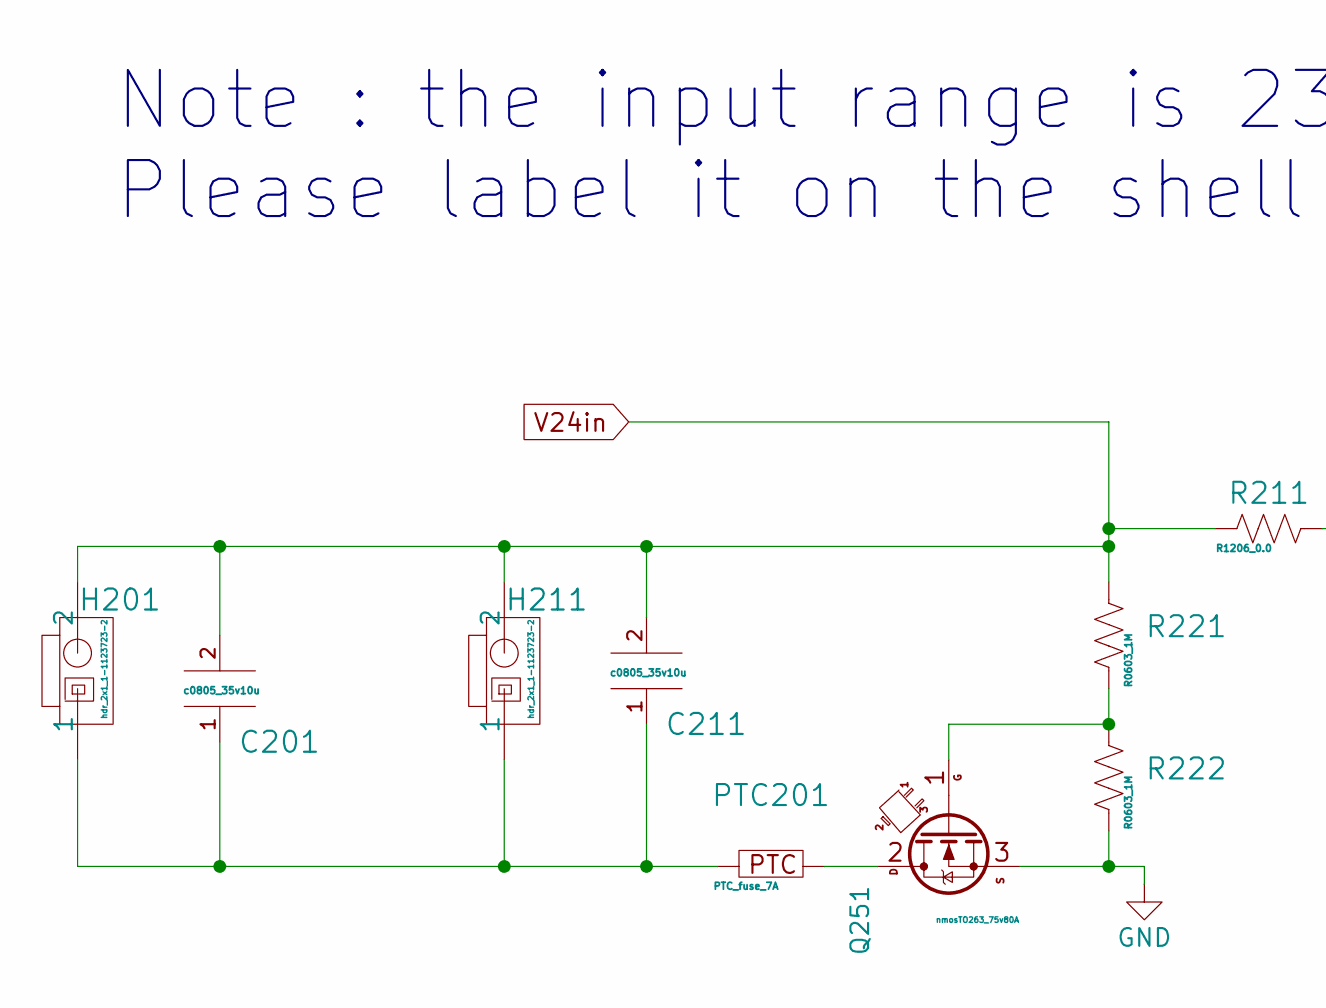
[picture p16: schematic 002_input28to22v.kicad_sch, part in row 1, column 1]

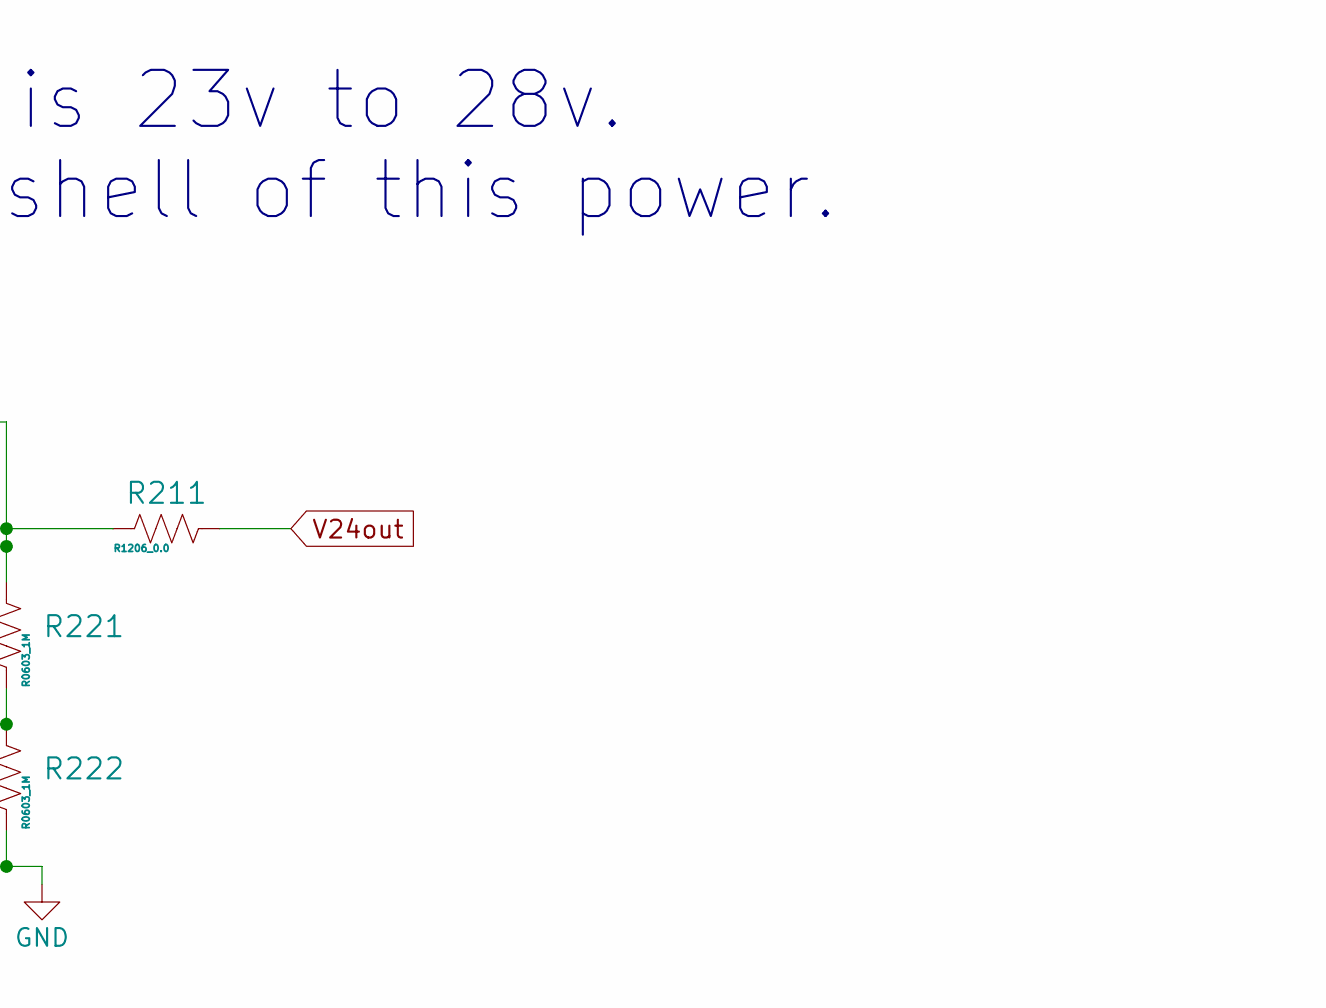
[picture p17: schematic 002_input28to22v.kicad_sch, part in row 1, column 2]

Parts:
C201, C211: c0805_35v10u; C0805mix0603; PartNum C2012X5R1V106M085AC
H201, H211: hdr_2x1_1-1123723-2; PartNum 1-1123723-2
PTC201: PTC_fuse_7A; ptc_fuse_2920; PartNum 2920L700/12MR
Q251: nmosTO263_75v80A; d2pak_TO263; PartNum IRFS3607TRLPBF
R211: R1206_0.0; R1206mix0603; PartNum RC1206FR-070RL
R221, R222: R0603_1M; C0603; PartNum ERJ-U03F1004V

Connections:
GND: Q251.3 (S), R222.1; also elsewhere on the board
unnamed: C201.1, C211.1, H201.1, H211.1, PTC201.1
unnamed: PTC201.2, Q251.2 (D)
unnamed: Q251.1 (G), R221.1, R222.2
V24in: C201.2, C211.2, H201.2, H211.2, R211.1, R221.2; also elsewhere on the board
V24out: R211.2; also elsewhere on the board

Notes on the sheet:
Note : the input range is 23v to 28v. Please label it on the shell of this power.

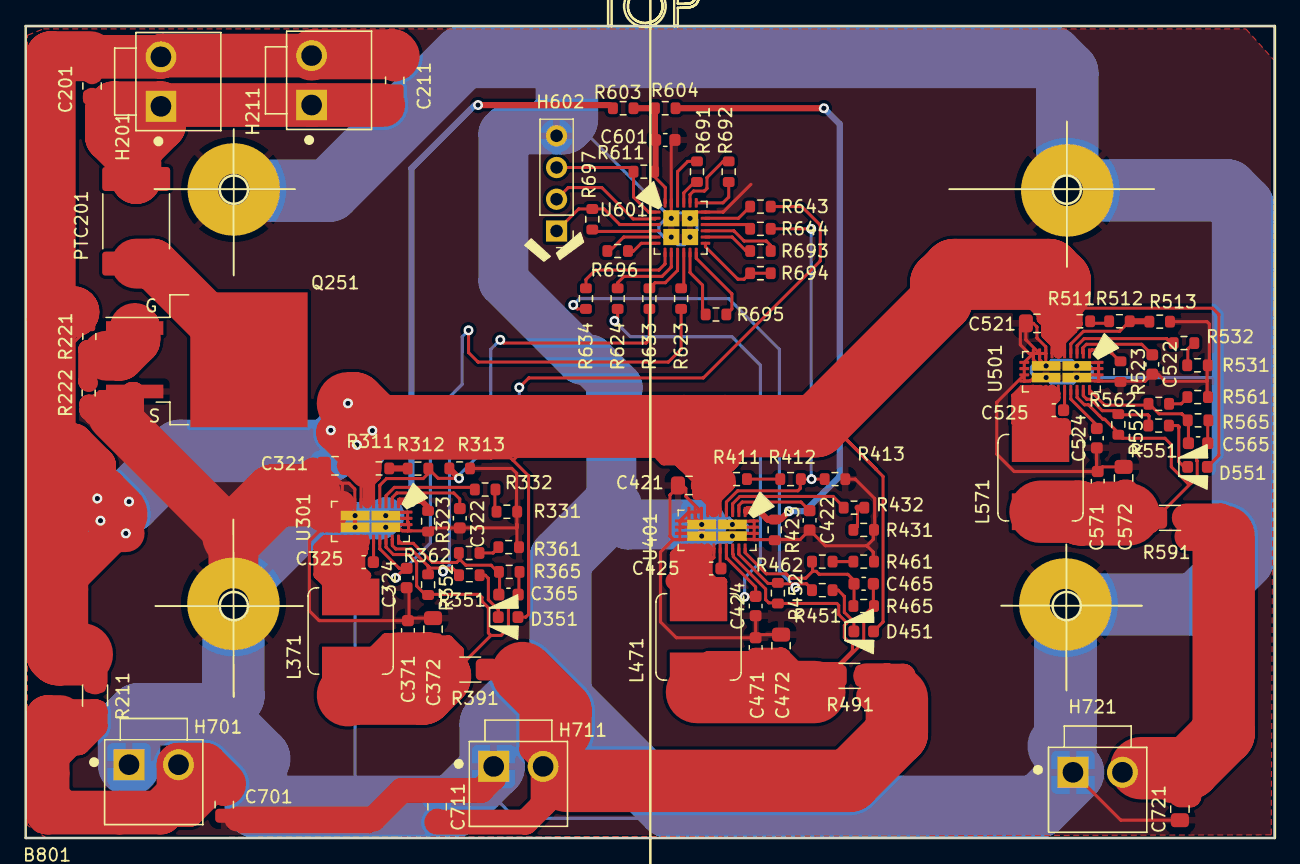
[picture p18: board kicad01_power_board_for_nuclear_team.kicad_pcb from above]

Board: 2 copper layers, 99.9 x 65.0 mm, 105 parts (0 on the bottom side), 72 nets.
